scottdube/shrink-fit/BOM.md

# Bill of materials — Shrink-Fit Induction Controller

Controller for the BT30 shrink-fit induction machine - isolated CAN supervision of the rectifier (CR-11)

**InvenTree part** `#782`  ·  **Build** `BO-0002` (Pending)

| Qty | Part | ID | Where it lives |
|---:|---|---|---|
| 1 | ADUM1201 Dual-Channel Digital Isolator | `18` | A3-R8C1 |
| 1 | AITRIP Type-C Supermini ESP32-S3 Dev Board 160MHz | `60` | B3-R6C3, LRD |
| 1 | SN65HVD230 CAN Transceiver Module | `19` | B3-R3C6, RB-25 |
| 1 | CG Solid State Relay SSR-100DD DC to DC Input 3-32VDC to Output 5-240VDC 100A Single Phase Plastic C | `193` | RB-25 |
| 1 | CGELE Aluminum Heat Sink SSR Dissipation for Single Phase Solid State Relay 10A,25A,40A Black Radiat | `192` | RB-25 |
| 2 | Brass Tee Compression Fitting 3/16in OD (5 pack) | `788` | B3-R3C8, RB-25 |
| 1 | MBR60100PT Schottky Rectifier 60A 100V TO-3P | `12` | B3-R2C4, RB-25 |
| 1 | B0505S-1W Isolated DC-DC Converter 5V 1W | `27` | B3-R2C7, RB-25 |
| 1 | Copper Tubing 3/16in OD x 5/32in ID, 5ft | `787` | Assembly & Test |
| 1 | NEMA 6-20P Plug, Male Cord End | `784` | Receiving |

## Notes on individual lines

- **Copper Tubing 3/16in OD x 5/32in ID, 5ft** — Induction coil / cooling circuit tubing
- **NEMA 6-20P Plug, Male Cord End** — Mains cord end, SR-02 cord-and-plug disconnect

---

_Generated from InvenTree on 2026-08-19 — do not edit by hand._
_Regenerate:_ `itq run link_repos.py && write_boms.py`
