scottdube/shrink-fit/hardware/guard-plate/Sketch1.dxf

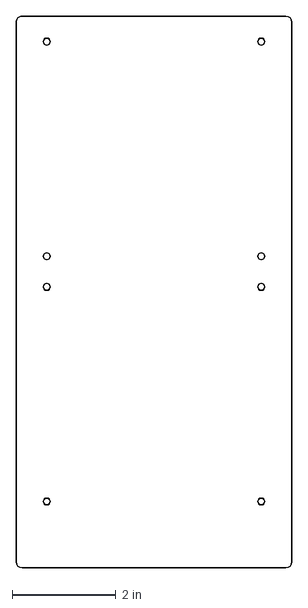
[picture p1: CAD file, 2026-08-29]
hardware/guard-plate/Sketch1.dxf
5.31 x 10.6 in
