scottdube/shrink-fit/(list of files, cad)

Other CAD files:
hardware/guard-plate/Heat Shrink Machine Bottom Guard Plate.dxf
