scottdube/shrink-fit/hardware/shrink-fit-controller/shrink-fit-controller.kicad_pcb

## KiCad design hardware/shrink-fit-controller/shrink-fit-controller.kicad_pcb (2026-09-03)

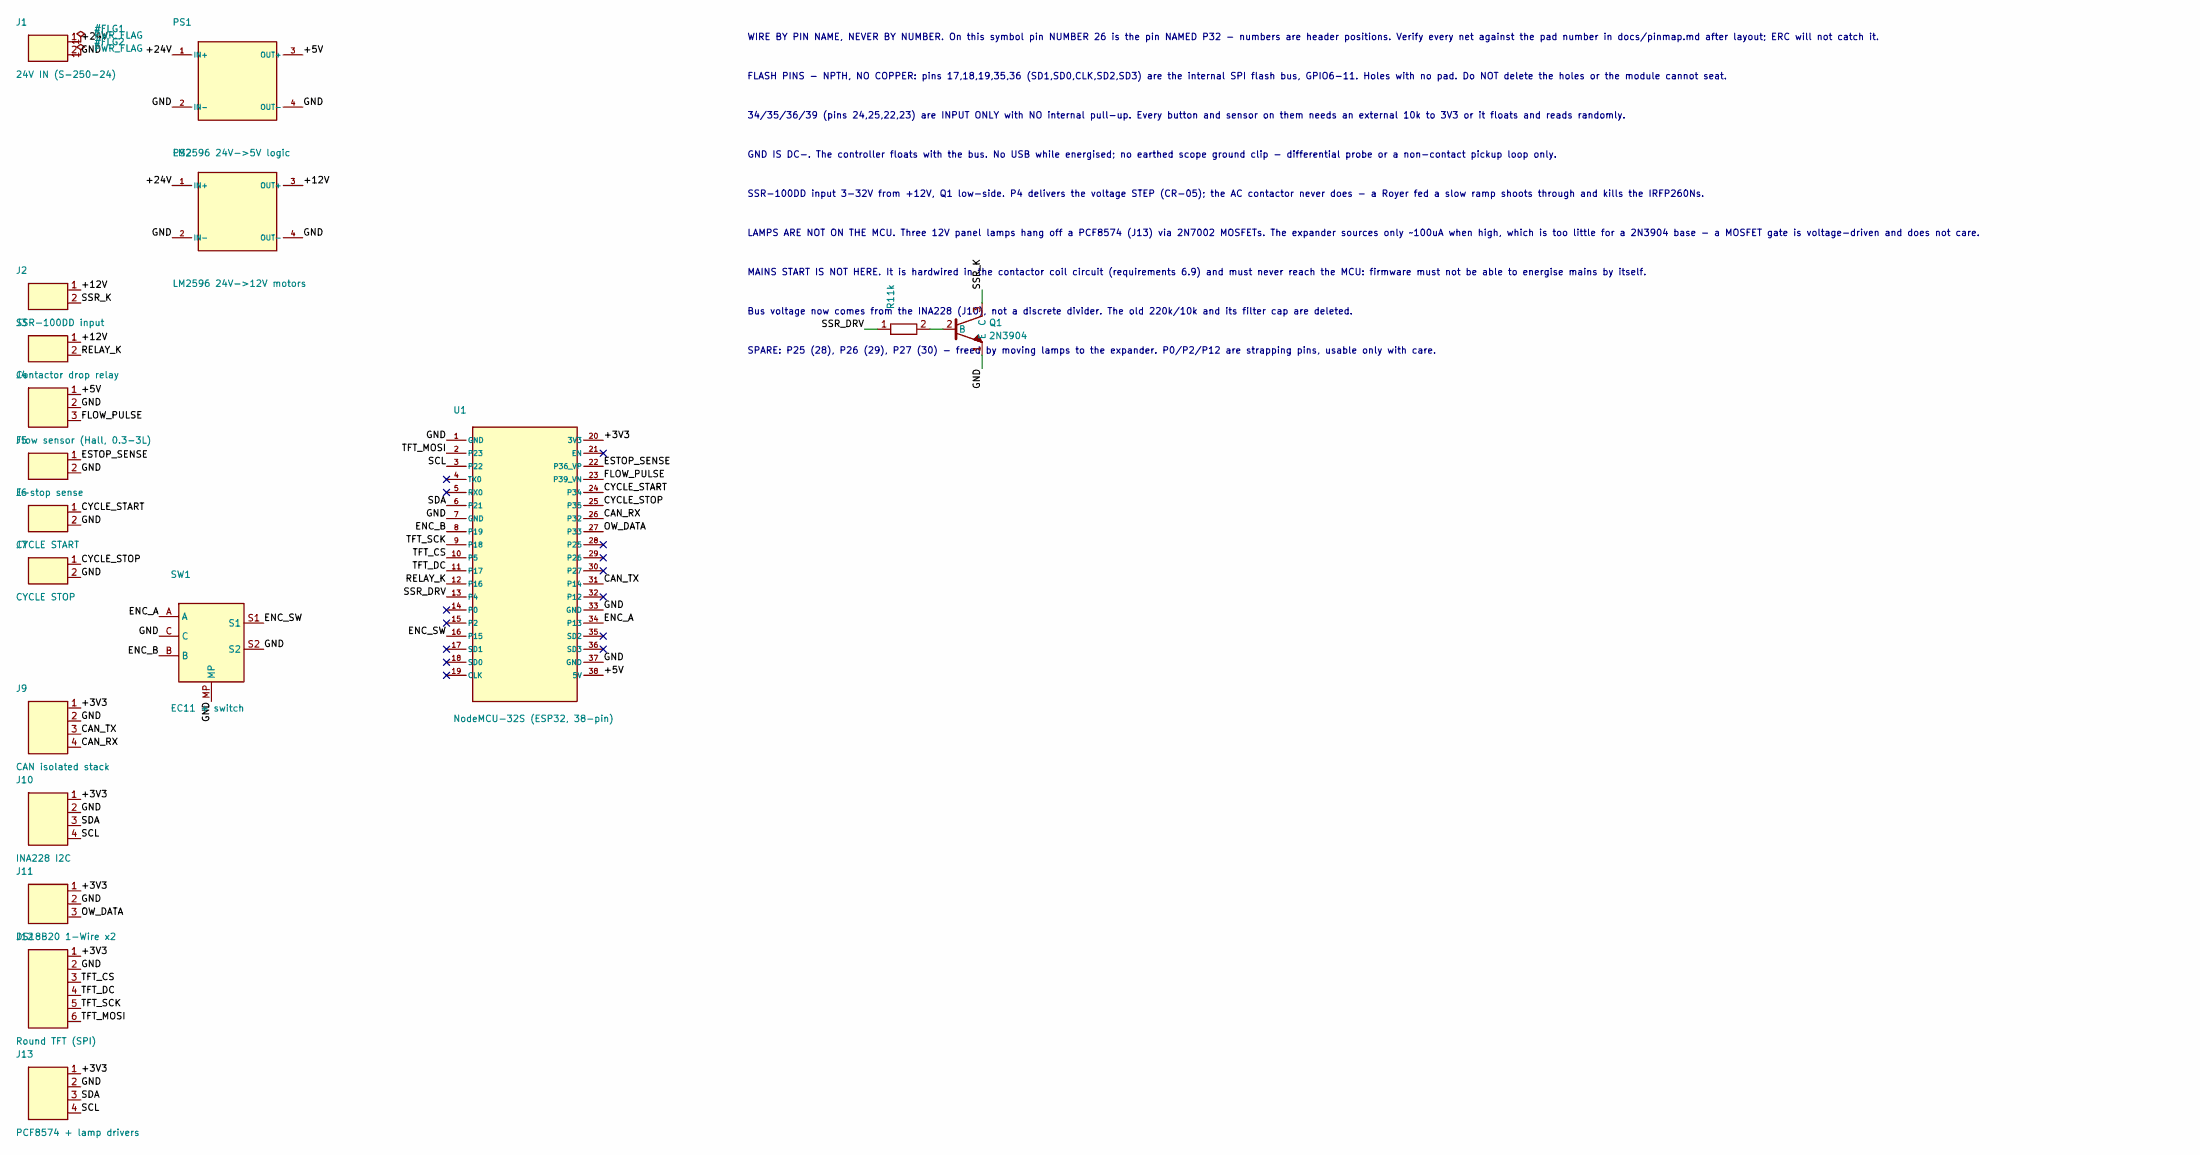
[picture p2: schematic shrink-fit-controller.kicad_sch, Shrink-Fit Induction Controller]

Parts:
J1: 24V IN (S-250-24); PinHeader_1x02_P2.54mm_Vertical_1.78pad
J2: SSR-100DD input; PinHeader_1x02_P2.54mm_Vertical_1.78pad
J3: Contactor drop relay; PinHeader_1x02_P2.54mm_Vertical_1.78pad
J4: Flow sensor (Hall, 0.3-3L); PinHeader_1x03_P2.54mm_Vertical_1.78pad
J5: E-stop sense; PinHeader_1x02_P2.54mm_Vertical_1.78pad
J6: CYCLE START; PinHeader_1x02_P2.54mm_Vertical_1.78pad
J7: CYCLE STOP; PinHeader_1x02_P2.54mm_Vertical_1.78pad
J9: CAN isolated stack; PinHeader_1x04_P2.54mm_Vertical_1.78pad
J10: INA228 I2C; PinHeader_1x04_P2.54mm_Vertical_1.78pad
J11: DS18B20 1-Wire x2; PinHeader_1x03_P2.54mm_Vertical_1.78pad
J12: Round TFT (SPI); PinHeader_1x06_P2.54mm_Vertical_1.78pad
J13: PCF8574 + lamp drivers; PinHeader_1x04_P2.54mm_Vertical_1.78pad
PS1: LM2596 24V->5V logic; LM2596_Module_THT
PS2: LM2596 24V->12V motors; LM2596_Module_THT
Q1: 2N3904; TO-92_Inline
R1: 1k; R_Axial_DIN0207_L6.3mm_D2.5mm_P10.16mm_Horizontal
SW1: EC11 + switch; RotaryEncoder_Alps_EC11E-Switch_Vertical_H20mm
U1: NodeMCU-32S (ESP32, 38-pin); NodeMCU-32S_38pin_THT

Connections:
/+3V3: J9.1, J10.1, J11.1, J12.1, J13.1, U1.20 (3V3); also elsewhere on the board
/+5V: J4.1, PS1.3, U1.38 (5V)
/+12V: J2.1, J3.1, PS2.3
/+24V: J1.1, PS1.1, PS2.1
/CAN_RX: J9.4, U1.26 (P32)
/CAN_TX: J9.3, U1.31 (P14)
/CYCLE_START: J6.1, U1.24 (P34)
/CYCLE_STOP: J7.1, U1.25 (P35)
/ENC_A: SW1.A, U1.34 (P13); also elsewhere on the board
/ENC_B: SW1.B, U1.8 (P19); also elsewhere on the board
/ENC_SW: SW1.S1, U1.16 (P15); also elsewhere on the board
/ESTOP_SENSE: J5.1, U1.22 (P36_VP)
/FLOW_PULSE: J4.3, U1.23 (P39_VN)
/GND: J1.2, J4.2, J5.2, J6.2, J7.2, J9.2, J10.2, J11.2, J12.2, J13.2, PS1.2, PS1.4, PS2.2, PS2.4, Q1.1 (E), SW1.C, SW1.MP, SW1.S2, U1.1 (GND), U1.7 (GND), U1.33 (GND), U1.37 (GND); also elsewhere on the board
/OW_DATA: J11.3, U1.27 (P33)
/RELAY_K: J3.2, U1.12 (P16)
/SCL: J10.4, J13.4, U1.3 (P22)
/SDA: J10.3, J13.3, U1.6 (P21)
/SSR_DRV: R1.1, U1.13 (P4)
/SSR_K: J2.2, Q1.3 (C)
/TFT_CS: J12.3, U1.10 (P5)
/TFT_DC: J12.4, U1.11 (P17)
/TFT_MOSI: J12.6, U1.2 (P23)
/TFT_SCK: J12.5, U1.9 (P18)
unnamed: Q1.2 (B), R1.2

Notes on the sheet:
WIRE BY PIN NAME, NEVER BY NUMBER. On this symbol pin NUMBER 26 is the pin NAMED P32 - numbers are header positions. Verify every net against the pad number in docs/pinmap.md after layout; ERC will not catch it.
FLASH PINS - NPTH, NO COPPER: pins 17,18,19,35,36 (SD1,SD0,CLK,SD2,SD3) are the internal SPI flash bus, GPIO6-11. Holes with no pad. Do NOT delete the holes or the module cannot seat.
34/35/36/39 (pins 24,25,22,23) are INPUT ONLY with NO internal pull-up. Every button and sensor on them needs an external 10k to 3V3 or it floats and reads randomly.
GND IS DC-. The controller floats with the bus. No USB while energised; no earthed scope ground clip - differential probe or a non-contact pickup loop only.
SSR-100DD input 3-32V from +12V, Q1 low-side. P4 delivers the voltage STEP (CR-05); the AC contactor never does - a Royer fed a slow ramp shoots through and kills the IRFP260Ns.
LAMPS ARE NOT ON THE MCU. Three 12V panel lamps hang off a PCF8574 (J13) via 2N7002 MOSFETs. The expander sources only ~100uA when high, which is too little for a 2N3904 base - a MOSFET gate is voltage-driven and does not care.
MAINS START IS NOT HERE. It is hardwired in the contactor coil circuit (requirements 6.9) and must never reach the MCU: firmware must not be able to energise mains by itself.
Bus voltage now comes from the INA228 (J10), not a discrete divider. The old 220k/10k and its filter cap are deleted.
SPARE: P25 (28), P26 (29), P27 (30) - freed by moving lamps to the expander. P0/P2/P12 are strapping pins, usable only with care.

Board: 2 copper layers, 18 parts (0 on the bottom side), 25 nets, no tracks yet.

Other parts of the board:
J8: Encoder EC11; PinHeader_1x05_P2.54mm_Vertical_1.78pad

Their connections:
/+3V3: J8.1; also elsewhere on the board
/ENC_A: J8.3; also elsewhere on the board
/ENC_B: J8.4; also elsewhere on the board
/ENC_SW: J8.5; also elsewhere on the board
/GND: J8.2; also elsewhere on the board
