scottdube/shrink-fit/(commit log)

2026-08-20 Shrink-fit induction controller: firmware and design docs
    BT30 induction shrink-fit machine — bring-up and test-rig firmware, R48 CAN
    interface, energy metering, plus requirements, roadmap and status docs.
    Adds a .gitignore first: .pio/ was 26 of the project's 27 MB — build output,
    third-party library clones, and a firmware.map embedding absolute local paths.
    None of it belongs in the history.
    BOM.md is generated from InvenTree (part #782, BO-0002, fully allocated) and
    records where each part physically lives.
2026-08-23 Drilled retention knob earns its place twice
    MR-16 already rested on the drilled knob venting the blind bore. Scott,
    2026-08-23: it is also the passage a welding wire runs up to push a stuck shank
    out during removal. So a solid knob does not just re-instate the hold-down
    requirement, it removes the recovery path for a stuck tool -- and that second
    consequence has no substitute.
    Recorded here and in shop-inventory/docs/TRAPS.md because the purchasing view
    and the machine-design view each only saw one of the two reasons.
2026-08-26 Bus divider moves to 220k/10k; SSR driver is a 2N3904
    Both changes come from checking stock properly instead of specifying first and
    sourcing later.
    180k does not exist here - the EAONE kit steps 100k -> 220k -> 300k - so the
    19:1 divider was never buildable. 220k/10k gives 23:1, keeps 53.5V at 2.33V,
    and changes one value. Rejected 100k+68k+10k in series (18.8:1): it hits the
    number, but spends three parts and two extra joints to avoid a calibration the
    `cal` command performs anyway, and every added joint sits in the sense path of
    a kW oscillator.
    The driver was going to be a 2N7000 that had to be ordered and is marginal at
    3.3V anyway (Vgs(th) to 3.0V). 24x 2N3904 were already in L2-D4.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
    [config.h, testrig.cpp]
2026-08-26 KiCad project for the controller: full scope, staged populate
    Skeleton only - .kicad_pro with the milled-board DRC, a validated empty
    schematic, and the design captured in hardware/README.md.
    Scope is the full Phase 2 controller with every block footprinted, populated in
    stages. Rejected a Phase-1-minimum board: it mills sooner, but the cost of a
    respin is not the copper, it is desoldering everything already fitted. A
    footprint on a board being milled anyway is free, so the asymmetry only runs one
    way. Note this is NOT the enclosure's "expensive to redo" argument - a milled
    board is an afternoon - and the two should not be conflated.
    DRC values are copied from sln-geo-aux-heat's .kicad_pro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
    [shrink-fit-controller.kicad_sch]
2026-08-26 Super Mini symbol, built from photographs of the actual board
    The pinout came from the two images already attached to InvenTree part #60 -
    Scott's own photos of both faces, iPhone-EXIF 2026-08-15 - not from a vendor
    listing. That distinction is the whole point: reading a stock listing as fact
    is what produced two wrong claims earlier in this session.
    Using both faces rather than one is also deliberate. Handedness is the failure
    that costs a board, and a single view cannot detect a mirror - the solder-side
    image has to mirror the component-side image, and it does. HW-747 V0.0.2 on the
    silk also confirms the board variant against platformio.ini rather than assuming
    "38-pin ESP32" is a specifi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
2026-08-26 Dimensions from the drawing; logic supply resolved to LM2596
    The dimensioned drawing is a third independent source for the pinout and it
    arrives rotated 90 degrees from both photographs with the labels still matching.
    That matters more than the millimetres: a mirror cannot be detected from one
    view, and three views in three orientations is what actually rules it out.
    23.50 x 18.00 board, and the 20.32 pin span self-validates the pitch at exactly
    8 x 2.54 - so pitch never needs measuring. One number is still missing: the
    row-to-row hole centre distance, which the drawing does not dimension and which
    cannot be read off a render because the pads overhang the outline. 17.78mm is
    recorded as a P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
2026-08-26 Correct the 12V earth test: a 2-prong wall wart has no pin to meter
    The test as written was impossible. It called for metering the supply's V-
    against the earth pin of its own AC cord, and a Class II wall wart has no earth
    conductor at all. Corrected to meter against the MACHINE's chassis earth, which
    is earthed through the NEMA 6-20 cord and is where an unwanted bond would
    actually show up.
    The correction also changes the conclusion in the reassuring direction: no earth
    conductor means the output cannot be earth-bonded through its cord, so tying V-
    to DC- imports no earth reference and the SR-11 objection dissolves for this
    case. Kept the test anyway, because the answer flips completely if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
2026-08-26 Decompose the ZVS kit: 8 machine components were untracked
    Every core component of this machine - the ZVS module, the 53.5V PSU, the coil,
    the pump, the 12V adapter, the breaker and the ammeter - existed only inside one
    InvenTree record sitting at qty 0. Inventory would have answered "you own none
    of this" about a machine on the bench.
    Contents come from the seller's own Package Included list rather than from
    memory or from the photographs, so quantities are vendor-stated against a box
    that was received - neither divided nor inferred. Decomposed to match the
    established pattern (EAONE resistors, McIgIcM transistors): children carry the
    stock, #100 stays at qty 0 so the purchase history surv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
2026-08-26 Schematic drawn and netlist-verified; footprint adopted after de-trapping
    The schematic is generated (tools/gen_sch.py), not hand-drawn, so the pinout
    truth lives in one reviewed table instead of ninety mouse placements. ERC came
    back 0/0, but the check that matters is the netlist-vs-expectation table: all
    15 U1 nets verified on their header-position pads, and the divider and driver
    chains verified by full membership, catching nothing wrong precisely because
    the symbol was built from three sources first.
    Two generator bugs were caught by the validation loop itself: a regex
    alternation mangled the one-letter symbol names (R, C) when prefixing the
    embedded library, which cascaded into all 16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
    [shrink-fit-controller.kicad_sch]
2026-08-27 checkpoint: traps recorded, and a retraction on row spacing
    Retracting a claim made earlier today: the found footprint did NOT settle the
    Super Mini row spacing. Its 15.24mm was accepted because it was internally
    self-consistent, which is the same error as taking the first search hit - the
    number was never measured. A photogrammetric attempt is recorded in TRAPS.md as
    a negative result rather than deleted: the two pad columns disagreed by 1.35mm
    and the built-in self-check (pad 1 to pad 9 must equal exactly 20.32) returned
    25.16 and 23.79, so the scale was wrong and every derived number with it. The
    cheap decisive test needs no calipers - 0.600in straddles a breadboard centre
    channel and 0.7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
    [shrink-fit-controller.kicad_sch]
2026-08-27 The board already has its freewheel diodes; and the caps say 50 kHz
    Two corrections from putting a meter and a microscope on the actual board
    instead of reasoning about it.
    MR-22 was wrong about where the protection is needed. The underside carries six
    FR307 in parallel straight across the DC rails, cathodes to DC+ - a catch-diode
    array, correctly sized. I dismissed them twice for being 3 A parts on a 58 A
    bus, which compared a continuous rating against a transient duty: a catch diode
    only conducts while the choke field collapses, and the surge rating is 150 A
    each, so 900 A for 8.3 ms against ~58 A for a few ms. Sixteen times margin and
    1.4 mW average. Six small fast diodes beat one big sl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
2026-08-27 MR-22 closes: the machine already has every diode it needs
    The SSR is a CoG ZGT-100 DD - 100 A / 220 VDC output, 3-32 VDC control, load on
    the positive side. That was the open question, and 220 V against a 53.5 V bus is
    4x headroom rather than the 5-60 VDC that would have made a transient dangerous.
    But the headroom is not why MR-22 closes. The onboard FR307 array clamps the FAR
    end of the SSR cable, so it protects the SSR as well as the board. When the SSR
    opens, the chokes freewheel into those diodes and hold the board input at about
    -0.7 V; the cable current then decays into the same diodes at 0.7 V / 2 uH =
    350 kA/s, clearing 58 A in ~166 us with only the clamp voltage across the cable.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
2026-08-27 12V supply verified from the nameplate, not inferred from the plug
    Model 1230: AC 100-240 V in, 12 V 3 A out, centre-positive, Class II mark
    present, 2-prong. The Class II mark is the load-bearing part - it is what makes
    the SR-11 bond structurally impossible rather than merely absent, and it is now
    evidence instead of an inference from "it looks like two prongs".
    Also records what the nameplate says that nobody would think to ask: dry
    location only, which matters solely because this shares a cabinet with a water
    loop, and centre-positive, which matters when it gets wired to a terminal
    instead of a barrel jack.
2026-08-27 Bench measurements close the footprint and delete the cut-away plate
    Row spacing measured at 15.2 mm, confirming the found footprint's 15.24 and
    finally killing my 17.78 prediction - which was geometrically impossible all
    along, since 17.78 on an 18.00 mm board puts the hole centres 0.11 mm from the
    edge. I had the drawing that ruled it out and did not check it against the
    prediction.
    Standoff height is 26.9 mm, which is more generous than assumed and removes a
    fabrication requirement: the carriage needs only a plain flat plate, because
    nothing can bridge that gap to the live underside. The cut-away or insulated
    plate previously specified is unnecessary.
    Added one check that these raise ra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
2026-08-27 Coil exits the board's short end: the layout was right, the saving is not
    Terminal geometry measured: 70 mm centre-to-centre, 13 mm off the board, and the
    leads exit the short end in the plane of the board. Mounted long-edge vertical
    with that end down, the coil hangs below - so the "coil beside the board"
    alternative, which would have bought 65 mm of column height, does not exist.
    Upright stays at ~520 mm, or ~480 with the nest dropped flush. Recording the
    negative result because the 65 mm was carried as an open lever for two days.
    13 mm against 26.9 mm of standoff puts the stubs inside the gap with ~11.5 mm
    clear beneath, confirming a plain flat carriage plate for the third time.
    70 mm i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
2026-08-27 Standoffs isolated: plain carriage plate confirmed, RF caveat recorded
    All eight brass standoffs measure open to both DC+ and DC-, so no tank potential
    reaches the carriage plate, the rail, or the column. Plain metal plate bolted
    straight to the blocks - fourth independent confirmation, and the last of the
    three fabrication features this measurement session deleted.
    Recorded the caveat that the measurement does NOT cover, because it would be easy
    to read "isolated" as settled: DC isolation is not 100 kHz isolation. The plate,
    rail and column are a large chassis-bonded conductor inches from the tank and are
    capacitively coupled to it regardless. The layout consequence is that sensor
    leads mu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
2026-08-27 Guard plate: hole pattern derived from the fan standard, not measured
    Scott's point, which I talked past twice: the eight brass standoffs ARE the fan
    bolt pattern. Two 80 mm fans stacked touching give exactly eight holes - two
    columns 71.5 apart, four rows at 0 / 71.5 / 80 / 151.5 - and eight is the stud
    count the kit sheet states. The 8.5 mm gap between the inner rows is where the
    two fan frames meet, 4.25 in from each frame edge, which is the fingerprint
    confirming the derivation rather than a coincidence.
    So the pattern needs no measuring at all. gen_guard.py derives it from fan size
    and pitch, which means a different fan size is a one-line change rather than a
    re-measure.
    Slots are fun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
2026-08-27 Fans are 120 mm: envelope corrected, +45 mm of column, easier rail
    The roadmap carried "2x 80 mm fans, 200 x 150 x 120" for this block. Two 120 mm
    fans stacked are 240 mm on their own, so that envelope was never possible - it
    went unchallenged because nobody multiplied it out. Now ~250 x 140 x 150.
    Costs about 45 mm of column: upright ~565 mm, or ~525 with the nest flush.
    Buys something back on the rail, though. A longer board lets the two carriage
    blocks sit further apart, and 180 mm centres instead of 140 cuts the per-block
    moment couple by 22% for free. A 450 mm rail still covers it - 390 needed at the
    wider spacing - so the rail decision is unaffected.
    Guard plate regenerated by chang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
2026-08-27 Guard plate 270x135, solid - the drainage argument does not survive vertical
    Sized to Scott's numbers: 270 x 135 gives ~2 mm clear each end on the long axis
    and covers the heatsink fins, which stand ~4 mm proud of the board edge. Stud
    pattern centred: X columns 105 apart, Y rows 7.5 / 112.5 / 127.5 / 232.5, M3
    clearance at 3.4 which laser kerf opens to a useful ~3.5.
    Removed the slots. They were for leak drainage - a solid plate under a
    HORIZONTAL board turns the standoff gap into a tray, and that gap holds the
    coolant terminals. But the board stands long-edge vertical, which makes the gap
    a vertical slot that drains out its own open bottom edge. The reason was sound
    for the orientation I f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
2026-08-29 FIRST CONTROL: the SSR closed on command
    testrig.cpp flashed and run for the first time - written 08-15, compiling clean
    since, never loaded because PlatformIO had vanished and I recorded it as needing
    reinstall. Opening the VS Code extension rebuilt penv on its own, which is what
    the status note guessed would happen.
    Commanded r 5, GPIO10 held high for exactly 5000 ms, SSR control LED lit for the
    duration. That closes the Phase 1 control chain end to end: GPIO10 -> R1 -> Q1
    -> SSR-100DD control input. Every link in it is now measured rather than
    designed.
    Two bench details worth keeping. Scott caught that USB 5V and the 5V pin are the
    same net on the Super Mini before wiring the LM2596 in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
    [Heat Shrink Machine Bottom Guard Plate.dxf, Sketch1.dxf]
2026-08-29 SSR output proven: Phase 1 control circuit is complete
    12 V through 1 k through the SSR output, meter across the SSR: 12 V idle, near
    zero for the full commanded 10 s, back to 12 V. Output transistor conducts and
    releases on command, so the chain GPIO10 -> R1 -> Q1 -> SSR control -> SSR output
    is measured end to end. Nothing in it is inferred any more.
    Correcting the record on two things that looked like faults and were not. The run
    that appeared to last a second was my test script writing a newline to "just
    listen" - the firmware aborts on any incoming byte, which is correct and
    documented behaviour. And 12 V across the SSR reads as blocking, not passing;
    measuring across a switch is inver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
2026-08-29 State indication: lamps carry state, a TFT would carry numbers
    Recording the requirement Scott raised - the machine must show which of IDLE /
    HEATING / COOLDOWN / FAULT it is in - along with the argument that settles the
    hardware question, because it is not the obvious one.
    A 1.28in round TFT is richer and it is the wrong primary indicator, for a reason
    that has nothing to do with cost or effort: a frozen TFT still shows its last
    frame. A hang, a locked SPI bus, a crash mid-cycle, and it sits there reading
    HEATING when nothing is heating - failing deceptively, toward exactly the reading
    you least want to trust. A lamp driven by a live loop stops blinking when the
    loop stops, so its failure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
    [config.h, testrig.cpp]
2026-08-29 Test rig runs untethered: two buttons and a state lamp, no laptop
    GPIO48 confirmed by observation - all three patterns read correctly on the bench.
    It is a plain LED, not the addressable RGB I assumed from a photograph, and
    driving it with neopixelWrite() had been producing meaningless flicker. Also
    worth recording that this is the LED that looks like a power indicator; the
    module has no separate one, which is why it read as "always on" before.
    Both buttons verified from the serial log captured while they were pressed:
    start, abort at 4347 ms of a commanded 10 s run, and the refusal during cooldown.
    Every path exercised.
    This is the change that actually matters for safety rather than conve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
    [config.h]
2026-08-29 Two Waveshare round LCDs are owned; the display argument is unchanged
    Catalogued #470 at qty 2 - the fourth uncatalogued item surfaced today after the
    ZVS kit contents, whatever is on WS1, and the 1/8in acrylic. The pattern is
    consistent enough to be worth naming: components are tracked, materials and
    modules are not.
    Marked the count as a STATED MINIMUM rather than a tally, per the evidence tiers
    - Scott said "at least two", which is not the same claim as two. Also recorded
    that these are genuine Waveshare rather than clones, because clone GC9A01 boards
    differ in pinout and init sequence and that distinction costs a debugging session
    if it is lost.
    This makes the Stage-4 data display cost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
2026-08-30 Correct the LCD provenance: mixed, not confirmed genuine
    I recorded "GENUINE Waveshare, not a clone" from a passing remark and hardened it
    into a fact. Scott's follow-up is that one may well be a clone. Corrected to what
    is actually known: two units, GC9A01 class, both with the 8-pin Waveshare header
    arrangement, provenance mixed.
    The 8-pin header is the useful part and worth keeping - it means the wiring
    should match the Waveshare reference regardless of who made the board. What it
    does not guarantee is the controller: boards sold as GC9A01 sometimes ship an
    ST7789 or a different init sequence. So the instruction is verify the controller
    on first use, not the branding, which is the check t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
2026-08-30 status.md: retire two entries that are no longer true
    The controller section still said testrig.cpp had never been flashed and that
    PlatformIO needed reinstalling. Both were true when written and both were
    resolved yesterday - the extension rebuilt penv by itself, and the rig has since
    run untethered on buttons. Struck through rather than deleted so the sequence
    stays legible: the original note predicted the reinstall, and it was right.
2026-08-30 Duration button for the rig: built and compiling, deliberately NOT flashed
    The calibration protocol is an iteration on duration - "heat ~25% longer, try
    again, repeat" - so with duration settable only over USB, every step of the
    actual job would mean plugging a laptop back in. That defeats the buttons, and
    it would have bitten the first time a tool did not go in rather than during
    repeat 20 s runs.
    Third button steps a ladder (5/10/15/20/30/45/60, wrapping) and blinks the new
    value back as one flash per 5 s, so the setting is readable with no display and
    no serial. Same principle as the state lamp: pattern carries the signal.
    Idle only. Changing duration mid-run would make the log disagree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
2026-08-30 R-11 CONFIRMED: the PZEM reads 44% low inside the field
    The PZEM reported 29.7 V during a run while a second meter on the same PSU
    terminals read 53 V+ throughout. The supply never sagged. R-11 has been carried
    as "suspected in the first-light readings" since 2026-08-09; this is the direct
    measurement that settles it.
    Withdrawing today's coupling and equilibrium figures. They were computed from
    PZEM power readings and those readings are now known to be wrong by at least 44%
    on the voltage channel - in the direction that makes delivered power look lower
    than it is, which is the direction that invites longer cycles to compensate.
    Two things survive. The coupling argument is geometric: a 5/8i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
2026-08-30 OTA for the test rig, gated to idle only
    WiFi credentials live in NVS and are set once over serial (wifi <ssid> <pass>),
    so nothing lands in git and the rig still works with no network configured at
    all - it just skips WiFi and says so.
    ArduinoOTA.handle() is called ONLY when state == IDLE. An update cannot start,
    and cannot proceed, while a cycle is running or cooling. onStart also forces the
    field off as belt and braces, though the guard means we should never arrive there
    hot. An update landing mid-cycle with the field on is the failure this is written
    to prevent.
    Verified rather than assumed that OTA is actually possible here: default.csv
    carries app0/app1 at 0x140000 each, so there are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
    [config.h, testrig.cpp]
2026-08-30 Record the no-OTA-password decision so it does not read as an oversight
    I built OTA without setPassword() and only noticed when asked whether it was
    safe. Scott's call is to leave it open: bench rig, trusted shop LAN, machine
    never unattended.
    Recording it in config.h rather than leaving it implicit, because an unlocked
    OTA on a controller that switches 53 V into a 3 kW heater looks exactly like a
    mistake to anyone reading later - including me. The note says it was considered,
    names the conditions it depends on, and gives the two-line fix for when those
    conditions change.
    [config.h]
2026-08-30 OTA works: VLAN reverse path and WiFi power save, in that order
    Two independent faults, and separating them was the whole job. The IoT VLAN
    blocked espota because it needs the DEVICE to open a connection back to the
    laptop, and IoT rules permit LAN->device while blocking device->LAN. Ping
    succeeded throughout and told us nothing, which is the trap worth remembering.
    Scott's test - put the laptop on the same VLAN - isolated it in one move.
    Separately, Arduino leaves WiFi power save on, so the radio sleeps between
    beacons: 42-140 ms latency before, 4-8 ms after WiFi.setSleep(false). That fix
    was delivered over OTA, which proved the loop end to end.
    The diagnostic that mattered was mDNS. shri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
    [testrig.cpp]
2026-08-30 Duration ladder to 10 s rungs, and hold-to-go-down
    Scott's call on 10 s rungs, and it fixes the read-back as a side effect: one
    flash per 10 s makes the whole ladder 1..6 flashes. The 5 s version put 60 s at
    twelve flashes, which nobody can count - I picked one-flash-per-5s without
    thinking about what the top of the range looked like.
    Little is lost. These timed cycles exist for coil comparison and rough
    exploration; the machine doses on ENERGY, so fine time resolution is the wrong
    instrument for the job it is eventually doing.
    Added hold-to-step-down because the first version could only wrap. Being at 30
    and wanting 20 cost six presses, and the calibration protocol converges from both
    sid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
    [testrig.cpp]
2026-08-30 One indicator, one signal - the three-lamp argument, found on the bench
    I gave the rig's single LED two jobs: a continuous state pattern and a transient
    count for the duration read-back. They collide. A readout flash cannot be told
    from a state flash, so the count gains or loses a blink depending on when the
    button is pressed relative to the idle pattern. Scott found it in minutes of
    actual use.
    Recording it against the three-lamp decision in this file because it is the same
    mistake at small scale, and it converts that decision from an argument into an
    observation. The rule is one indicator carries one signal; a second thing to say
    needs a second lamp, not a cleverer pattern on the first.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
2026-08-30 LED read-back gets a dark bracket; record the two TC clocks
    The single status LED carries a continuous state pattern and a transient
    duration count, and Scott found they blend: press the button near an idle
    blink or a cooldown gap and the count gains a phantom flash at one end.
    500 ms of darkness either side of the readout makes it countable. This is
    a legibility patch, not the fix -- one lamp per signal is the fix, and
    roadmap.md already argued for it before I built this.
    Rejected the alternative of encoding duration differently (long/short
    pulses, a burst rate): it keeps two signals on one lamp and adds a code
    Scott would have to memorise. Counting flashes needs no key.
    TRAPS: TR-04's 20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
    [testrig.cpp]
2026-08-30 Idle displays the duration continuously; the button only changes it
    Scott asked how long to wait after a duration press before pressing
    again to check the setting. There is no such interval, and the question
    exposed the defect: every press stepped the value, so pressing to read
    incremented, and pressing again to confirm incremented again. He had been
    chasing the setting he was trying to observe.
    The dark-bracket patch an hour ago made the count legible and left this
    untouched -- symptom, not cause. Idle is now N flashes + 1.6 s gap on
    repeat, so the duration is on display whenever the rig is not running,
    and the button is a write-only control.
    Rejected a read-only gesture (double-tap, or a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
2026-08-30 First real temperature, and the current channel falls too
    320 C in 30 s on 1" bar with an unpacked thermocouple -- a floor, not a
    peak. Inside the 250-400 C shrink window on a coil that is still shorted
    turn-to-turn. The gate question (has this thing got the power at all?)
    is answered yes.
    PZEM current read 3.5 A against 23 A on the clamp. Recorded the energy
    argument rather than the instrument comparison, because the comparison
    does not actually prove anything: if the clamp was round a tank
    conductor, 3.5 A DC in and 23 A circulating is unremarkable for a
    resonant load. 3.5 A at 53 V for 30 s is 5.6 kJ, and 300 K into even a
    100 g slug needs ~14 kJ -- impossible regardless of clamp placeme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
2026-08-30 Strike the PZEM validation from Proven; the DC clamp was never bought
    Scott asked what the second clamp meter was for. The answer is in
    bom.md: the UNI-T UT210E was explicitly DECLINED, because a Hall DC
    clamp has to sit on the DC lead inside the field that corrupts every
    other sense lead, whereas the AC clamp reads mains at 60 Hz feet from
    the coil and is RF-immune by placement. Today proved that call right --
    the mains clamp gave the number we trust, the in-field PZEM did not.
    status.md still listed a DC clamp as the bring-up reference, which
    contradicted bom.md and would have sent us buying one; removed.
    Also struck 'PZEM validated against the AC clamp = 88% efficiency' from
    the Proven l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
2026-08-30 The '10% of target' figure was the same PZEM error, restated
    Caught while answering a question about which clamp meter is which:
    'Power is ~10% of target' sat two lines below the PZEM validation I had
    just struck, and derives from the same 297 W reading. Real input measured
    at the mains is ~1.8 kW -- around 60% of the kit rating.
    This one had teeth. A tenfold power deficit and a 1.7x deficit call for
    different projects: the first says the topology or the supply is wrong,
    the second says wind a better coil. The roadmap's coil work was already
    the right move; it was being justified by a number that overstated its
    payoff by 6x.
2026-08-30 DC clamp reads 33 A: confirms the mains math, refutes my vindication claim
    Independent confirmation first: 33 A on the feed against 32.6 A derived
    from the mains clamp an hour earlier, two different physical principles
    at opposite ends of the machine, inside 2%. The input power figure is now
    solid in a way no single instrument could have made it.
    Backing out a claim I made this afternoon. I wrote that the day
    'vindicated exactly' bom.md's decision to decline a DC clamp -- the
    argument being that a Hall clamp near the tank would be corrupted like
    everything else. Scott then used one to take the decisive reading, in
    that same field, uncorrupted. The PZEM's vulnerability is its sense
    leads; a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
2026-08-30 Temper colours corroborate the thermocouple, and map the coupling zone
    Oxide bands read ~310 C at the bored end against 320 C on the
    thermocouple. Worth more than the small numeric gap suggests: a K-type
    junction in an RF field and a surface oxidation reaction share no failure
    mode, so this is the first temperature figure not resting on a single
    instrument -- which matters on a bench where the last two instruments
    both lied.
    The gradient is the better half of the photograph. The bands draw the
    coupling zone without needing a probe: hot over the top two-thirds,
    steep transition, cold foot. That was the free parameter in this
    morning's energy reconciliation, which had to assume 60-70% of the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
2026-08-30 The coil was never shorted; the coupling deficit is geometric
    Scott asked what 'shorted coil' meant. It meant nothing -- I had carried
    'turns touching (shorted)' forward from an earlier note without checking
    it against quickstart-1-8.md, which specifies winding turns touching AND
    insulating them. Touching is the design; only bare touching turns short,
    and the coil carries the sleeving design-references.md A5 calls for.
    Not just wrong, load-bearing. I twice presented 320 C as achieved
    despite a handicap, which implied headroom sitting in a repair. The
    actual deficit is geometry: a 25 mm bar in the stock 60 mm coil couples
    to (25/60)^2 = 0.17 of the bore. Both diagnoses point at 'rewind the
    c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
2026-08-30 Haas publishes no temperature spec; a low-reading TC defeats CR-02
    Fetched 04-1424 rather than relying on the docs' 'not published' note:
    the page carries bore, gage, concentricity and RPM and no thermal
    parameter of any kind. That closes the waiting half of OQ-3 -- there is
    no Haas figure coming, and the 350 C ceiling is ours to defend rather
    than a spec to cite.
    Pushed back on Scott's read that a low thermocouple is manageable with
    time and power. It is, for reaching temperature. It is precisely wrong
    for the ceiling: CR-02's 350 C flag and 375 C lockout fire on the
    thermocouple, so a probe reading low never trips them and 380 C actual
    displays as 340 C with the holder tempering. CR-02 is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
2026-08-30 TC identified from photo: Adafruit glass braid, trim the tip sleeve
    Photograph settles it -- white fiberglass braid with blue tracer and a
    black anti-fraying sleeve at the tip, which is the Adafruit part. The
    smoke was that sleeve and nothing else, so there is no PTFE exposure and
    nothing to buy: trim it and the probe is rated 500 C against the ~130 C
    it was being run at.
    Recorded the failure mode the trim opens up, because it is the kind that
    does not announce itself. A thermocouple reads at the hottest point
    where its two conductors touch, not at the bead -- the bead is the
    junction only because it is the sole contact. Once the outer braid can
    fray, a second contact further back in a hott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
2026-08-30 The TC tip sleeve is marked 125 C -- its operating limit, not its shrink point
    Scott read the 125 C marking as the temperature at which the tubing
    shrinks. On heat-shrink that number is the maximum continuous operating
    rating; polyolefin shrinks at roughly 90-120 C. The distinction is worth
    recording because it changes what the marking was telling us: not a
    processing note but the limit itself, printed on the part, while it ran
    at 2.5x it.
    Confirms the material as polyolefin rather than PTFE, which retires the
    polymer-fume-fever caution raised earlier -- acrid, not hazardous.
2026-08-30 OQ-3 answered: Haas states 400 C, and our 30 s cycles are just arithmetic
    Scott found the HSF-325 operation manual -- Haas's own shrink-fit
    machine. It states twice that the maximum recommended heating
    temperature is 400 C and that above it toolholders may be damaged. Our
    ceiling is 350 C, and its recorded justification was that no
    manufacturer figure existed. It does now.
    That matters beyond a number. requirements.md 4.3 estimated the 1/8"
    holder wants ~410 C, above our ceiling, and that was THE blocking risk
    for the project's stated goal. Against 400 C the gap is 2.5% on a
    figure the doc itself flags as unsourced.
    Recorded the decision rather than making it. Raising a limit that
    protects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
2026-08-30 Trace the 1.75 kW figure, and own peak-quoted-as-average
    Scott challenged the 1,800 W number. It holds -- 33 A DC clamp x 53 V
    second meter = 1,750 W with nothing assumed, corroborated independently
    from the mains end at 1,840 W less PSU losses. Recorded the derivation
    so it is not a number people have to take on faith again.
    Two honest weaknesses recorded alongside it. The 240 V mains was taken
    from an old status.md line and never put to Scott; what actually
    supports it is that the two paths only agree at 240 V, which is
    inference rather than a reading. And both currents are PEAKS that I then
    multiplied by 30 s as though sustained -- resistivity climbs and
    coupling shifts as the work heats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
2026-08-30 1.75 kW is an operating point, not a capability -- and that is a hazard
    Scott's second challenge to the number was the right one. The
    measurement holds (33 A steady, 240 V AC confirmed), but a Royer draws
    what its load permits, so what I measured is what THIS coil and THIS bar
    demand. I used it to characterise the machine, which it does not do.
    The consequence is not bookkeeping. Draw is 33 A of an available 56.1 A,
    so there is ~1.7x headroom, and improving coupling is precisely what
    collects it. The 19.5 mm coil is a large coupling improvement over the
    60 mm one, which means a 30 s cycle that gave a 300 K rise could
    approach a 500 K rise on the new coil -- past 400 C, into holder damage,
    o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
2026-08-30 Bracketing protocol for the first real holder
    Scott's rule: underestimate the time and add to it rather than trying to
    predict it. Correct, and for a reason worth stating -- under-heating
    costs a cycle, over-heating costs a holder, and lopsided costs mean
    there is no case for aiming at the centre.
    Recorded three refinements the bare rule does not cover. Heat is
    cumulative, so a second attempt on a 200 C holder is not a run from
    ambient and fixed increments accelerate up the ladder. The hazard band
    is MARGINALLY under rather than well under -- a nearly-expanded bore
    takes the tool partway and seizes on it, which is worse than a bore that
    refuses it, so creeping up in 1 s slices maximises exp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
2026-08-30 Phase-2 stock check: CAN fully covered, current sense entirely absent
    Scott's instinct was right on both counts. CAN needs nothing bought --
    three SN65HVD230s, three ADuM1201s for isolation, and the ESP32-S3's
    internal TWAI replaces the MCP2515 the BOM still lists. Marked that line
    stale.
    Current sensing has nothing at all. The Hall parts in stock are magnetic
    field sensors rather than current sensors -- usable only with a core and
    a calibration campaign, which is a project and not a part.
    Recorded a reconsideration of the INA228 rather than just pricing it.
    It is a shunt sensor with sense leads in the field, which is the exact
    architecture that failed today, while the DC clamp -- Hall, no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
2026-08-30 CR-02 assumes the measurement CR-01 exists to avoid
    Scott asked how a thermocouple attaches to a tool holder. It does not:
    holders are loaded and unloaded every cycle, cannot be drilled or
    clamped, and a spring probe on a 400 C nose has worse repeatability than
    the quantity it reads. CR-02 specifies sampling nose temperature and
    never specifies the mechanism.
    The contradiction beneath it is worse than the omission. CR-01 energy
    dosing exists BECAUSE per-cycle holder temperature is unmeasurable;
    CR-02 assumes it is measurable. Both cannot hold, and CR-02 is the one
    with no mechanism behind it.
    Haas decides the direction: their production machine measures no
    temperature at all, running diame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
2026-08-30 Drop the MAX31855: coolant is a 1-Wire job, and nothing else needs K-type
    Scott: a K-type and a cold-junction-compensating amplifier for water
    that never passes 60 C is the wrong instrument. Two DS18B20 waterproof
    stainless probes are already in stock at B3-R4C8.
    The removal goes further than CR-07. With CR-02 rewritten so temperature
    characterisation happens at calibration rather than per cycle, and
    calibration running on Scott's own DMM probe against a drillable witness
    piece, nothing in the design needs a K-type amplifier at all. Both
    probes and the breakout come off -- ~ and one less board to mount.
    Recorded two properties worth more than the saving. 1-Wire carries a
    CRC8, so a corrupt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
2026-08-30 Withdraw the ACS758: I reasoned from a property that did not carry over
    Scott asked where it goes in the circuit. In series with the DC bus,
    same place as the shunt -- and the question is what broke the argument.
    I had recommended it on the strength of the DC clamp working in the
    field. But the clamp survived because it has no galvanic connection to
    the circuit and senses at the jaws; the ACS758 sits in the circuit and
    sends analog down a wire. The property that did the work does not carry
    across, and I never checked that it did.
    Worse, it costs the thing CR-01 depends on: feeding the ESP32 ADC moves
    energy integration into software and back under loop jitter, which is
    exactly what the INA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
2026-08-30 Withdraw the 'long analog path' story; the ratio test now gates the INA228
    Scott rejected the architecture argument I used to justify the INA228,
    and he was right for a reason worse than being wrong: he had already
    told me, during the RF diagnosis, that the PZEM's shunt is integrated
    with the board and has no leads. I built a causal story that contra-
    dicted his own bench observation and then spent a purchase on it.
    What survives is better than what I invented. The voltage channel has
    long sense leads and demonstrably responds to twisting them; the current
    channel has no leads at all, so its error cannot be lead-borne RF, which
    is what makes the scale-constant hypothesis credible. The two-f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
2026-08-30 Session close: bench queue for 2026-08-31, and retire the PZEM
    Recording the queue in order so tomorrow does not re-derive today.
    The headline change is that the decisive PZEM measurement no longer
    requires opening a live box. One simultaneous reading of PZEM current
    against the DC clamp separates the two live hypotheses: exactly 6.0 is a
    documented 50A/300A mismatch with a known fix, exactly 10.0 is outside
    the documented option set entirely. Community search found the failure
    mode is common and well attested but caps at 6x in every reported case,
    which is what makes the reading worth taking -- our own figures were
    eyeball recollections during a run, and 5.5 misremembered as 3.5 is the
    sli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
2026-08-30 E-stop on hand: APT LA39, correct for SR-03's coil-cutting role
    Scott has the E-stop, so CR-09 drops to the encoder alone. Recorded the
    part and, more usefully, the four things that decide whether it actually
    protects anything.
    It is right for the specified role: SR-03 cuts the DC contactor coil
    rather than the bus, and AC-15/DC-13 are coil-switching categories. It
    carries the positive-opening symbol, which is the marking that matters --
    contacts forced apart mechanically, so a welded contact still opens.
    Flagged the NC check first because it is the failure that hides: an
    E-stop on a normally-open contact mounts correctly, looks correct, and
    does nothing.
    Recorded the flyback-diode trap b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
2026-08-30 E-stop contact verified NC on the bench
    Scott metered it: released = closed, pressed = open. Normally closed,
    which is what SR-03 needs -- pressing it drops the contactor coil and
    opens the DC bus.
    Recording the verification rather than leaving the check open, because
    the failure it rules out is invisible: an E-stop on a normally-open
    contact mounts correctly, looks correct in a panel, and protects
    nothing.
2026-08-31 E-stop moves to the AC side; DC contactor retired (Scott's call)
    Scott: 'I want all of the deadly current killed if I have to hit the
    estop.' He had assumed all along that the contactor was on the AC side,
    and asking why it wasn't exposed a real weakness rather than a
    misunderstanding.
    The old SR-03 cut a DC contactor coil, dropping the ZVS stage while the
    rectifier and all mains wiring stayed live -- 8.5 admitted this and
    answered it with 'a reachable plug is the disconnect'. An E-stop that
    leaves 240 V energised is answering the wrong hazard, and the hazard it
    misses is the one present during commissioning with hands near the
    board.
    The revision is also the easier engineering, which is w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
2026-08-31 CR-05 revised: the SSR delivers the step, and arming needs three gates
    Found while writing up Scott's startup sequence that CR-05 says 'switch
    the DC output, not the AC input' -- because a Royer needs a hard step to
    commutate and a slow ramp puts both MOSFETs into conduction at once.
    Section 6.9 moved the contactor to AC yesterday evening without my
    checking that.
    It survives, but by luck. MR-23 had already reassigned the hard step to
    the SSR, so the rectifier's ramp happens behind an open SSR and the ZVS
    never sees it. Had the SSR not already owned that job, 6.9 would have
    fed the Royer a slow ramp and destroyed the IRFP260Ns. CR-05's text has
    disagreed with MR-23 since MR-23 was written;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
2026-08-31 The shunt outlives the PZEM; tomorrow's flat-draw test decides it too
    Scott asked what happens to the shunt if the PZEM is retired. It is a
    separate part -- a bus-bar element in the positive lead -- so retiring
    the board leaves it bolted in the circuit.
    That makes the flat-draw test decide two things rather than one. If CAN
    can integrate energy, the shunt comes out as well: two bolted joints in
    a 33 A bus serving nothing, and every high-current joint is a candidate
    hot spot. If the INA228 is needed, the shunt is already its shunt.
    Recorded the part that closes a loop we spent the evening circling: the
    INA228 reports shunt voltage as a raw register, so the unmarked rating
    becomes irrelevant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
2026-08-31 Contactor selected: Baomain MC-9b-24VDC, and the listing that nearly lost it
    Verified live at $31.16, September 1 delivery. LS Electric Metasol MC-9b
    frame: AC-1 25 A against a 13.6 A load, 3NO mains poles, 1NO+1NC aux,
    24 V DC coil, UL and IEC 60947-4-1.
    Recording how close this came to being rejected. The Amazon spec block
    reads 'AC-1 (Resistive Loads): 25A 24V DC' -- literally a DC contact
    rating, which would make it the wrong part and unsafe on a 240 V feed.
    What saved it was Ui 690 V and Uimp 6 kV on the same page: nobody builds
    690 V insulation into a 24 V DC device. Confirmed against LS Electric's
    frame spec, which is 230/460 VAC with a DC coil option. The listing had
    pasted the coil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
2026-08-31 Power distribution: 24 V primary with split bucks, all from stock
    Scott's architecture -- one 24 V supply feeding the contactor coil
    directly and bucking down for the rest. The S-250-24 (24 V 10 A) is
    already on the shelf at WS2-S3 and there are fifteen LM2596 modules at
    A3-R7C2, so the entire power chain costs nothing.
    Two bucks rather than one, deliberately: a DC pump motor pulls 3-5x
    running current at startup, and sharing a rail drags the logic supply
    down at precisely the wrong moment. A controller brownout mid-cycle is
    an uncommanded state with the field on, which is worth five dollars of
    separation and would be an unpleasant intermittent to chase otherwise.
    Recorded the LM2596's rea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
2026-08-31 Order placed: contactor, panel buttons, INA228 — $62.14 inbound
    Recording what is on the way and, more usefully, what to check when each
    part lands, since three weeks from now the reasoning will not be in
    anyone's head.
    The contactor check matters most: its Amazon listing states the contact
    ratings as '25A 24V DC', which read literally would make it the wrong
    part on a 240 V feed. It is a listing error -- Ui 690 V and LS Electric's
    own frame spec settle it -- but the next person to open the box will see
    the same misleading text, so the note goes in the BOM rather than only
    in the commit.
    Flow sensor deliberately not ordered. No part was chosen because the
    search results are all HVAC padd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
2026-08-31 Flow sensor ordered: Hall-effect, 0.3-3 L/min
    Range brackets a small 12 V pump. Recorded why the obvious search
    results were wrong: the HVAC paddle switches that dominate results are
    sized for 1" pipe and would not actuate at this loop's flow at all,
    reading 'no coolant' forever or sticking closed. A wrong-scale sensor on
    a safety interlock is worse than none, because it looks fitted.
    Fitting notes recorded now rather than at install: threshold above the
    turbine's stall point rather than at it, mount where it stays flooded
    since a parked bubble reads as no flow, supply side for the cooler water
    against an ~80 C housing.
    Noted that this closes the last estimated figure in the power budget.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
2026-08-31 Four-instrument simultaneous read: range theory refuted, 1.77 kW reconfirmed
    Scott took the reading properly rather than from recollection: PZEM
    30.8 V / 3.10 A / 96.1 W against a DC clamp at 33.9 A and a KAIWEETS at
    52.30 V, with the AC clamp in the same frame.
    Current ratio is 10.94. Not 6.0, and not a ratio of any two values in
    the PZEM-025's 50/100/200/300 A range set, where the largest possible
    mismatch is 6x. The shunt-range hypothesis is refuted outright -- which
    is exactly what the test was designed to decide, and it is worth having
    killed rather than left plausible.
    Voltage ratio is 1.70, having been 1.78 and 1.60 on earlier readings. A
    scale error does not move. Corruption on tha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
2026-08-31 Measure tank frequency before running the 19.5 mm coil
    Scott asked how to measure coil inductance with the tools on hand. The
    answer -- pickup loop on the DHO914, derive L from the known 3.96 uF --
    surfaced something with a deadline attached.
    The caps are marked 50 kHz and design-references.md already records that
    both predicted coil bands sit above that. The 19.5 mm coil is predicted
    at ~108 kHz, roughly twice the rating, and it is the coil queued for the
    next session. Running MKPH parts at 2x rated frequency is dielectric
    heating with no warning until one fails, so the frequency measurement
    has to come before the long cycles rather than after.
    Recorded the pickup-loop method specifically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
2026-08-31 Work plan for 2026-08-31 morning
    Nothing ordered lands before Sept 1, so the day is measurement and
    machining. Ordered by value rather than by sequence, because a morning
    rarely survives contact with a bench.
    Block 3a -- the flat-draw test -- is first among the powered work
    because it decides both whether the INA228 gets returned and whether the
    shunt stays bolted in a 33 A bus. It runs on the existing coil, so it
    does not wait on any coil work.
    Block 2, the 5/8" witness bar, gates the entire coil A/B: the 1" bar
    does not fit the 19.5 mm coil, so without a common test piece the two
    coils cannot be compared at all and the coil log has no baseline.
    Block 1 asks whether the 19.5 mm coil is e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
2026-08-31 Block 1 result, plus the coil-bending and flow-test steps the plan lacked
    Block 0 and 1 done: TC sleeve trimmed, PZEM reassembled and installed,
    19.5 mm coil installable pending leg bending.
    Recorded the ordering constraint that the plan implied but never stated:
    Block 3 must run before the coil is swapped, because the baseline
    temperature run is the A of the A/B and needs the 60 mm coil fitted.
    Swapping first destroys the comparison the witness bar exists to enable.
    Added two steps the plan skipped entirely. Annealing before re-bending,
    because copper at an existing bend is work-hardened and cracks when
    re-formed -- and the failure mode is a leak onto a live board, which is
    the hazard the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
2026-08-31 Witness-bar hole moves off mid-length: the probe cannot exit there
    Scott asked whether bending the K-type wire 90 degrees to route it up
    through the coil was acceptable. Bending is harmless -- chromel/alumel is
    ductile. The destination was the problem.
    quickstart-1-8.md specifies cross-drilling at mid-length and that was
    written without checking whether the thermocouple can physically leave
    the hole. A 19.5 mm bore around a 15.875 mm bar leaves 1.8 mm per side
    against a ~2.5 mm braided probe: it does not fit, and forcing it crushes
    the braid and presses the conductors together, which is the false-
    junction failure already recorded. A wire routed up the bore would also
    sit in the strongest p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
2026-08-31 Block 3 result: 310 C baseline, and the draw is flat enough for CAN
    60 mm coil, 1" bar, 30 s, surface sanded bright first so the oxide reads
    this run rather than cumulative history. Peak ~310 C, current 32 A
    climbing steadily to 36.8 A.
    Three runs by three methods now agree at 310-320 C. The reproducibility
    matters more than the figure: a rig that answers differently each time
    cannot be calibrated, and calibration is the whole remaining project.
    This is the 'before' for the coil A/B.
    The flat-draw question resolves in CAN's favour. A 15% rise over 30 s is
    0.5% per second; at 1 Hz that is 30 samples on a monotonic ramp, and
    trapezoidal integration of a linear ramp is exact. Even the midpoin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
2026-08-31 19.5 mm coil first light: 3x the heating on 2/3 the power, and the bus collapses
    100.37 kHz measured with a pickup loop on the DHO914, against 108 kHz
    predicted -- the model was good. Derived inductance 0.635 uH.
    The headline is that it works: 250 C in 10 s against 310 C in 30 s on the
    old coil, roughly three times the heating rate. The surprise is that it
    does so on LESS power. Bus collapses from 52.3 V to 18.0 V under a
    67.3 A draw, so input is 1,211 W where yesterday was 1,773 W. The
    numbers close on coupling alone -- 1773 x 0.17 = 301 against 1211 x 0.66
    = 802, a 2.7x ratio against the ~3x observed.
    Corrected my own first reading: the supply is CURRENT-limited, not
    power-limited. A cur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
    [testrig.cpp]
2026-08-31 TOOL IN A HOLDER -- the near-term goal is met
    A carbide tool is shrunk into a Haas BT30 1/8" holder on the 19.5 mm
    coil. That was the project's stated near-term objective and it is done.
    It took 25 s, a cooldown, then 10 s. Recording that split rather than
    just the success, because it is the supply derating made physical: a
    single long cycle underperforms as the R48 protects itself, falling from
    1,211 W to 795 W by 25 s, and the gap let it recover so the second run
    went in nearer full power on an already-hot holder. Roughly 35 s split
    achieved what ~15 s at sustained full power would have.
    That makes the multi-layer rewind a throughput argument rather than an
    elegance one. Raising tank imp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
2026-08-31 Heat placement confirmed correct, and 4.3's 410 C estimate closed at 285 C
    Photograph of the successful holder shows deep purple confined to the
    clamping section, gold-straw at the shoulder, and the flange, drive
    slots and BT30 taper bright and untouched. My concern that a 30 mm coil
    against a 15 mm clamp length would spread heat onto the taper was
    unfounded -- placement is right and there is nothing to change.
    The band is even around the full circumference, which says the coil sat
    concentric and heated uniformly. Recording that as a free per-cycle
    quality check: an off-centre coil would show as an uneven band, and no
    instrument in this shop reports concentricity any other way.
    The bigger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
2026-08-31 Reheat repositions a shrunk tool; depth collars specified
    30 s + cooldown + 15 s released and re-seated an already-shrunk tool to
    a chosen depth, against 25 + 10 for the original insertion. The
    difference fits -- a reposition is a release and a re-seat in one heat,
    and Haas's table shows shrink-out running 15-20% longer than shrink-in.
    The capability matters more than the numbers: a mis-set depth is
    recoverable rather than a ruined holder, which is worth knowing before
    it happens on a tool that matters.
    Still purple at ~285-290 C on both cycles, and the colour line still has
    not passed the nose taper. Heat placement holding under repetition is
    better evidence than the first photo was -- on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
2026-09-02 Close OQ-5: controller moves to a 38-pin ESP32, test rig stays on S3
    The board change was agreed in conversation yesterday and never written
    down -- the docs still assumed the Super Mini everywhere, so the loop was
    genuinely open and Scott was right to ask.
    Two boards, two purposes. The test rig stays on the S3 Super Mini
    because it works: OTA proven, TWAI clean, buttons and LED done. Its
    footprint work stays valid and in use; it just does not carry to the
    controller. That also means today's INA228 I2C work goes on the S3 with
    no conflict and nothing waiting.
    The controller moves to a 38-pin ESP32, ~5 of which are already in
    stock. The strongest reason is not the pin count but the instabil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
2026-09-02 INA228 bring-up sketch on a separate 38-pin ESP32
    Scott's call, and better than mine: test I2C on a new dev board rather
    than adding it to the working rig. The rig has OTA, TWAI, buttons and a
    duration ladder all proven, and there is no reason to risk that to try a
    new peripheral. It also starts the ESP32 port incrementally instead of
    as one migration later, and tests I2C on the silicon that will actually
    carry it.
    Raw register access rather than the Adafruit library, deliberately.
    During bring-up a wiring fault should read as a wiring fault, not as a
    library that 'doesn't work' -- one fewer layer between the operator and
    the chip.
    The sequence matters too: prove the board is alive BEFORE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
    [ina228_test.cpp]
2026-09-02 Board identified: NodeMCU-32S, the variant with the proven footprint
    Silk reads 5V rather than VIN, and pin names are P-prefixed rather than
    D/GPIO. Both tells match NodeMCU-32S, which is the variant this shop
    already has a proven NodeMCU-32S_38pin_THT footprint for -- so the
    controller PCB needs no new footprint and takes no exposure to the
    mirroring failure that has hit two footprints here already.
    That was the last open item on the 6.12 board decision, and it landed
    the favourable way: had it been a DOIT DevKit-V1 the footprint work
    would have had to be redone from measurements.
    Recorded the instruction to mark the other boards in the bin. There are
    at least four different 38-pin produc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
2026-09-02 OTA on the INA228 bring-up board; flashed and verified booting
    Flashed to the NodeMCU-32S over USB. Boot output confirms
    ESP32-D0WD-V3 rev 3 at 240 MHz and I2C initialising on sda=21 scl=22.
    Scan returns nothing, which is the correct answer with no INA228 wired
    yet -- a clean negative from working firmware rather than a failure.
    Added WiFi and OTA because the same argument that justified it on the
    test rig applies here: the board should not have to be carried to a
    bench for every firmware change.
    Hostname is shrinkfit-ina228, deliberately different from the rig's
    shrinkfit-testrig. Both boards will be on the same network and an mDNS
    collision would send a flash to the wrong one -- a failur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
    [ina228_test.cpp]
2026-09-02 espota needs the laptop on the device's VLAN -- recorded after the second time
    The INA228 board joined IoT cleanly, reported its OTA server running,
    and answered mDNS -- and espota still failed with 'No response from
    device' because the laptop was on 192.168.1.x against the board's
    192.168.30.x.
    espota runs backwards from the intuition: the host invites and the
    DEVICE connects back to the host. Across VLANs with no reverse route
    that return connection never lands, and every device-side symptom looks
    healthy because the device side is healthy. That is what makes it cost
    time -- there is nothing wrong to find on the board.
    Same fault as the test rig's OTA bring-up on 2026-08-27. Recording it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
    [ina228_test.cpp]
2026-09-02 Correct the misleading touch-test banner (NOT YET FLASHED)
    The banner told the operator to touch VIN+/VIN- and watch VSHUNT move.
    That cannot work with R002 fitted: the pads are shorted through 2
    milliohms and a finger is around a megohm, so the shunt wins by a factor
    of ~500 million. Scott tried it, saw nothing, and reasonably wondered if
    the board was faulty. It was my instruction that was wrong.
    The touch test only works AFTER R002 comes off and the inputs float.
    What actually proves the chip before rework is MFG_ID 0x5449 and
    DEVICE_ID 0x2281, both of which read correctly -- so the gate for
    desoldering is already passed.
    *** THE BOARD IS RUNNING THE PREVIOUS BUILD. *** OTA needs the la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
    [ina228_test.cpp]
2026-09-02 INA228 bring-up complete on the NodeMCU-32S
    Genuine part confirmed by MFG_ID 0x5449 and DEVICE_ID 0x2281, not merely
    an address that acknowledges. R002 removed, VIN+ to VIN- now 35 MOhm --
    open for any purpose here, since against a 750 uOhm shunt that diverts
    two parts in a hundred billion. Analog front end responds. OTA verified
    end to end.
    Done on a board deliberately separate from the S3 test rig, so a working
    machine was never at risk while a new peripheral was brought up.
    Recorded two bad instructions of mine rather than quietly dropping them.
    The touch test cannot work with R002 fitted (2 mOhm against a finger's
    megohm) and, worse, does not work after removal either -- touching both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
2026-09-03 Pin map for the NodeMCU-32S controller — the doc the schematic gets built from
    Scott's point, and he is right: the instability argument justified
    headroom, not paralysis. With a board that has spare GPIOs a requirement
    change costs a pin reassignment rather than a respin, so there is no
    reason not to narrow the design down now.
    Settling the pin map before touching KiCad because changing the MCU
    re-pins everything -- the existing schematic still carries the S3 Super
    Mini as U1 and is stale against essentially every decision since.
    Two constraints recorded that would each cost a board. CAN RX must not
    land on GPIO12: a transceiver's RX idles HIGH, GPIO12 must be LOW at
    boot, and the module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
2026-09-03 Pin map: PCF8574 for the lamps, not dropping the display
    An earlier draft led with 'drop the TFT and four pins come back', which
    framed a decision Scott had already taken as the problem. He wants a
    display and encoder for settings; the display is not what needs to give.
    The lamps are. They are slow static outputs -- exactly what an I2C
    expander is good at -- and the I2C bus already exists for the INA228, so
    moving them costs zero MCU pins and about a dollar. GPIO 25/26/27 come
    back as clean spares.
    That takes the board from 'the only spares are strapping pins' to real
    headroom with everything fitted. roadmap.md reached for the same part
    when the Super Mini was the constraint, and the reaso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
    [ina228_test.cpp]
2026-09-03 Record the telnet console, the macOS no-telnet trap, and a misfiled commit
    Telnet carries the console that OTA does not, and crosses the VLAN that
    espota cannot -- the device connects back to the host for espota, while
    telnet is an ordinary outbound connection. That asymmetry is what makes
    it worth having: firmware pushes still need the laptop moved to IoT,
    watching the stream does not, and the laptop cannot live on IoT.
    Also noted that macOS ships no telnet client, which is a two-minute
    confusion the first time and a documented one thereafter.
    Flagged that the telnet firmware landed inside bd0fbc7 -- a commit whose
    message is entirely about the pin map -- because I used 'git commit -a'
    an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
2026-09-03 Bring the proven NodeMCU-32S symbol and footprint into the controller project
    Both already existed in sln-geo-aux-heat, on a board that was built and
    works -- so the controller needs no new symbol and no new footprint, and
    takes no exposure to the mirroring failure that has hit two footprints
    in this shop. That was the payoff for identifying the board as a
    NodeMCU-32S rather than a DOIT.
    Added the GPIO -> symbol-name -> PIN NUMBER table, which is the artefact
    that actually prevents the wrong-pad failure. On this symbol names and
    numbers deliberately disagree -- names are GPIO, numbers are header
    position, and pin number 26 is the pin named P32. Wiring by number lands
    nets on the wrong GPIOs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
2026-09-03 TFT on board one, lamps on a PCF8574 -- and the driver changes to a MOSFET
    Both decisions taken. The expander returns GPIO 25/26/27, so the board
    has genuine headroom with the display fitted rather than only strapping
    pins spare.
    The part that matters is not the pin count. PCF8574 outputs are
    quasi-bidirectional: LOW sinks 25 mA, but HIGH is a weak pull-up
    sourcing only ~100 uA. That breaks the 2N3904 pattern proven on the SSR,
    because an NPN needs base current sourced INTO it -- 100 uA at hFE 150
    is about 15 mA of collector current, marginal for a lamp and worse over
    temperature.
    The failure mode is what makes it worth catching now: dim or
    intermittent lamps that work on a bench and sag i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
2026-09-03 Schematic rev B: NodeMCU-32S, 24 V primary, lamps off the MCU
    Regenerated against docs/pinmap.md. ERC 0 violations, and all 38 U1 pins
    verified independently -- nets on the named pins, no-connects on the
    rest, flash pins 17/18/19/35/36 explicitly NC.
    Changes from rev A: U1 is the NodeMCU-32S (proven symbol and footprint
    copied from sln-geo-aux-heat rather than redrawn); MAX31855 header
    deleted; power is 24 V in with two LM2596 bucks (5 V logic, 12 V motors
    and lamps) rather than a single 12->5; the 220k/10k bus divider and its
    filter cap are gone because the INA228 measures bus voltage now; and
    lamps, encoder, cycle start/stop, DS18B20 and the TFT are added.
    Two bugs ERC caught that readin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
    [shrink-fit-controller.kicad_sch]
2026-09-03 Footprints assigned; netlist verified against pad numbers
    18 components, 0 without a footprint, ERC 0 violations, and all 20
    critical nets confirmed landing on the correct U1 PIN NUMBER in the
    exported netlist -- CAN_RX on 26, SSR_DRV on 13, ENC_A on 34. That is
    the check that catches the wrong-pad failure; ERC does not.
    Generated project-local 2.54 mm headers rather than using KiCad's stock
    PinHeader library. The stock parts use 1.7 mm pads on a 1.0 mm drill,
    which on this shop's bit set snaps UP to 1.181 mm and leaves a 0.259 mm
    annulus against pcbmill's 0.25 mm gate -- passing by 9.5 microns, which
    is not a margin, it is luck. 1.78 mm pads give 0.299 mm and match the
    NodeMCU-32S_38pin_TH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
    [shrink-fit-controller.kicad_sch]
2026-09-03 Real footprints for the LM2596 modules and the EC11 -- both were placeholders
    Scott caught both. I had used generic 1x04 and 1x05 headers, which
    silently encoded a decision I never raised: that the buck modules and
    the encoder mount OFF the board and the headers are just wiring to them.
    LM2596: the proven LM2596_Module_THT footprint already existed in
    sln-geo-aux-heat, same source as the NodeMCU footprint -- 2.0 mm pads on
    a 1.0 mm drill, 0.410 mm annulus. Modules now mount on the board, which
    deletes eight flying leads. Pin order IN+/IN-/OUT+/OUT- confirmed from
    the source symbol before wiring, because a swapped in/out on a buck
    destroys it.
    EC11: a 1x05 header could not map onto the real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
    [shrink-fit-controller.kicad_pcb, shrink-fit-controller.kicad_sch]
2026-09-03 All four ordered parts arrived; the R002 is stocked, not taped to the board
    The 2026-08-30 order is in hand and on the books. The BOM's "keep the R002
    bagged and taped to the module" instruction is retracted, because its only
    purpose was keeping the return option open inside the 30-day window if the
    flat-draw test retired energy dosing. The module is staying: at 0.66 coupling
    the 19.5 mm coil collapses the bus 52.3 V to 18 V, and 1 Hz CAN telemetry
    cannot integrate a load that moves like that, so CR-01 needs the INA228.
    The resistor is stocked separately at Scott's direction (InvenTree part 1172,
    B3-R3C2) with its tolerance recorded as unverifiable — 2 mOhm reads as a dead
    short on every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
2026-09-03 PCF8574 and 2N7002 lamp drivers on the board as real parts
    The expander was a 4-pin header standing in for a decision. It is now a
    DIP-16 with real pin numbers so the stock Package_DIP footprint maps
    1:1, A0-A2 grounded for 0x20 (INA228 is at 0x40, no collision), 100 nF
    decoupling, and three 2N7002 low-side drivers. J13 becomes the lamp
    connector: +12V plus one cathode per lamp.
    The PCF8574 has no firmware; lamp logic lives in the ESP32, which
    writes one byte to 0x20. Recorded on the sheet that firmware should
    rewrite that byte every loop rather than only on change -- the expander
    holds its outputs if the MCU hangs, and a refreshed byte turns a hang
    into a lamp that stops responding instead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
    [shrink-fit-controller.kicad_sch]
2026-09-03 PCF8574 ordered; the listing does not know which variant it ships
    Bridgold 5-pack, $8.69. Title says PCF8574AP, package contents say
    PCF8574P -- the exact ambiguity flagged when the part was specified.
    Same pinout and same board either way; only the I2C address differs
    (0x20 vs 0x38 with A0-A2 grounded). Recorded that the firmware constant
    is set by reading the chip, not the listing, and that the bring-up
    sketch's scan reports the truth.
2026-09-03 R48 CAN protocol recorded from source, with the 56.1 vs 50 A trap
    Protocol taken from craigpeacock/Huawei_R4850G2_CAN's r4850.c rather than
    from memory: 125 kbps extended, request 0x108040FE at 1 Hz, telemetry
    0x1081407F with sub-ID in data[1] and a big-endian uint32/1024 in
    data[4..7], set commands on 0x108180FE with data[1] selecting voltage or
    current and online or offline.
    The trap worth the commit: the current command is a FRACTION of the
    rectifier's maximum, and the community code hard-codes that maximum as
    50 A for the R4850G2. Ours is an R48-3000e3 labelled 56.1 A. Copying the
    constant would mis-scale every current limit by ~12% -- a commanded 30 A
    landing near 33.7 -- and nothing o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
2026-09-03 CAN Stage 1 on the bring-up board: listen plus the 1 Hz request, no set commands
    TWAI in NORMAL mode on GPIO 14 TX / GPIO 32 RX -- not listen-only,
    because the R48 answers requests rather than volunteering, so the
    request frame has to be transmitted, and a normal node ACKs, which some
    R48 firmware wants to see before it keeps talking. The request is a read
    (0x108040FE, eight zeros) and cannot change anything on the rectifier.
    Decodes 0x1081407F replies: sub-ID in data[1], big-endian uint32 in
    data[4..7], divided by 1024. Tracks BOTH 0x81 and 0x82 as candidate
    output-current sub-IDs and prints both, because the community README and
    the community code disagree, and the bench decides which one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
2026-09-03 Record the CAN Stage 1 wiring and the decided test order
    CAN first at the rig with the R48 on mains and its DC output open; the
    PZEM box opens once afterwards to bring the shunt's Kelvin leads out;
    INA228 calibration then happens at the bench supply in CC mode. Scott's
    sequencing, and it means the box is disassembled once rather than twice.
    Wiring written down with the two traps inline: CAN RX on GPIO 32, never
    GPIO 12 (a transceiver's idle-HIGH RX on a must-be-LOW strapping pin
    means the board never boots), and the 220||270 termination because there
    is no 120 R in stock and the module's own three resistors are 10 k, not
    120 R -- Scott read the 01C marking, which is EIA-96 for 10 kOhm.
2026-09-03 WITHDRAW the Huawei CAN protocol: our rectifier is a Vertiv, not a Huawei
    Section 6.13 recorded the Huawei R4850G2 protocol and applied it to a
    Vertiv R48-3000e3. Different companies, different products. The
    datasheet says Vertiv on the front page; I searched for 'R48 CAN', found
    the extensively-documented Huawei part, and never checked that the model
    numbers actually matched. Every ID and encoding in 6.13 is wrong for
    this unit.
    6.14 has the real one, from anikrooz/Emerson-Vertiv-R48 -- a repo whose
    title names our exact model and which was reverse engineered from the
    Emerson M820B controller. Only the 125 kbps bit rate survives.
    The behavioural difference matters more than the IDs. The H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
    [ina228_test.cpp]
2026-09-03 Measured: the 2-pin JST is not CAN, and the card does not expose it
    Both JST pins float below 0.2 V against DC- with the R48 running. A
    recessive CAN pair idles at ~2.5 V on both lines by design, so this is
    not a CAN bus and never was. Section 2.1 reasoned its way to 'almost
    certainly CAN-H/CAN-L' from pin count and finger width, wrote 'confirm
    before connecting', and then firmware got written against the
    unconfirmed assumption anyway.
    That also explains the bench evidence cleanly. tx_err=128 with rx_err=0
    was the no-node-on-the-bus signature, not a protocol mismatch -- a CAN
    node ACKs any well-formed frame regardless of ID, so a rectifier
    listening on those wires would have acknowledged ev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
2026-09-03 ROOT CAUSE: the breakout card omits the comms interface by design
    An Amazon listing for the same class of R48-3000e3 adapter states it
    outright -- not the original factory interface board, does not have the
    original factory communication interface, only input and output. That is
    Scott's card: mains in, DC out, one 2-pin enable line, which is exactly
    what the meter found.
    So nothing was wrong with the transceiver, the wiring, the 220||270
    termination, or the firmware's bus setup. tx_err=128 with rx_err=0 was
    an honest report that there was no CAN node on those wires, because
    those wires are not CAN. The instrument was right the whole time and I
    kept looking for faults in things that were wor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
2026-09-03 Datasheet confirms CAN; the pinout is unpublished and the forums do not need it
    Vertiv's own datasheet, Control and Monitoring section: alarm and status
    reported via CAN bus to system controller. So CAN is factory capability
    reaching the card-edge connector, not a community hack.
    The same spec table corrects 6.14's scaling question: output current
    62.5 A at -48 V and current limit set point 0 to 62.5 A. The label's
    56.1 A is the same 3000 W at 53.5 V -- constant-power supply -- and it is
    62.5 that the CAN set command scales against, not the label.
    Recorded why Scott's instinct that this should not be a mystery is right
    and still leads nowhere: the pinout is genuinely unpublished across the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
2026-09-04 Module manual confirms the CAN feature set and explains the missing pinout
    UM1R481000e3 Table 1.7 lists what the rectifier accepts from a
    controller: Turn On/Off, Current Walk-in, HVSD Reset, Current Limit
    Adjustment, Voltage Regulation -- and what it reports back, including
    output voltage, output current and current limit setting. Everything
    CR-11 wants is a documented factory feature, not a community hack.
    The structural finding is why the pinout has been so hard to find: the
    module manual says to refer to the documentation of the SYSTEM the
    rectifier is installed in. The module plugs into a NetSure shelf and the
    backplane pinout belongs to the shelf's manual. The remaining document
    to ch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
2026-09-04 Documentation route closed: the backplane pinout is not published anywhere
    Searched the NetSure 731 A41 shelf manual in full, 38 pages. Its only
    connector table covers AC and DC distribution; the shelf manual treats
    the rectifier slot as a black box. Combined with both R48 datasheets,
    the 28-page module manual, four manual hosts, both community repos and
    two forums, this is no longer a search failure -- the document is not
    public.
    Also confirmed there is nothing to order. Scott was right: the eBay
    tail adapter is the same power-only card he already has, verified from
    its own product photo -- two DC terminals, a 3-position mains block, no
    comms. No CAN-bearing adapter has been found for sale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
2026-09-04 CORRECTED R48 protocol: IEEE-754 floats, not scaled integers
    The Endless Sphere thread Scott pointed at has far better protocol data
    than the GitHub repo, and it corrects the encoding I recorded in 6.14.
    Values are 32-bit big-endian floats, not (volts*10-320)*0x40000/10.
    Decoded all six of the post's example byte strings and every one lands
    exactly on its stated meaning -- 42240000 = 41.0 V minimum, 426A0000 =
    58.5 V maximum, 3F9AE148 = 1.21 = 121% of rated. That is settled.
    Second correction, and it would have been a silent 21% error: current is
    commanded as a FRACTION of rated, and the datasheet's 62.5 A IS the 1.21
    value. The 100% base is ~51.7 A, which independently matches the
    annotati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
2026-09-04 Two-node CAN bench test: verify our own hardware before blaming the rectifier
    Our CAN hardware has never been checked against a known-good node. It
    looked fine only because it was wired to something that may not be a bus
    at all, so there was nothing to fail against -- and tx_err=128 with
    rx_err=0 is equally consistent with OUR transceiver not driving as with
    nothing being there. This separates the two.
    Same binary on both boards, with GPIO27 choosing the role at runtime:
    open means talker, grounded means listener. Deliberate, so neither board
    can end up being 'the one with the wrong build' -- a failure mode that
    would look exactly like a hardware fault.
    Both nodes ACK each other, so a work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
    [can_loop.cpp]
2026-09-04 CAN bench test: read it from one port, and let the second node be any ESP32
    Two problems with the first cut, both raised by Scott.
    Reading it. It printed on each board separately, so proving a round
    trip meant watching two USB ports at once and correlating counters by
    eye -- a bad way to run a test whose whole value is a clean yes/no. The
    listener now echoes every frame back on ID 0x124 and the talker reports
    whether it came home, so ONE monitor on the talker tells the story and
    the listener only needs power. It blinks GPIO2 per frame so it can be
    seen working with no monitor at all. The talker also prints an explicit
    PASS/FAIL/MARGINAL verdict naming the likely cause, rather than raw
    count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
    [can_loop.cpp]
2026-09-04 Add 'ping' to the dev board rather than repurposing it for the CAN test
    Scott asked whether the board we have been developing on gets taken over
    for the two-node test. On inspection it should not, for a reason that
    matters more than convenience: that board, its SN65HVD230 and its wiring
    ARE the suspect. A test between two fresh boards would pass and prove
    nothing, because it would exonerate hardware that was never accused.
    Its TWAI config is already identical to can_loop's -- 125 kbps, NORMAL,
    GPIO14/32 -- so it needs no reflash to be the node under test, only a
    mode that pings something that will answer. 'ping' toggles the 1 Hz
    frame from the R48 request to a plain 0x123 and reports round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
2026-09-04 Ping mode: clear the controller on entry, and count a jam as one fault
    Both fixes came from actually running it on the board rather than from
    reading it, and both would have produced a confident wrong answer at the
    bench -- the exact failure this test exists to rule out.
    Entering ping mode now restarts the controller. Measured: after the
    rectifier attempt the controller sits error-passive with frame N still
    retrying, so twai_transmit only ever returns queue-full and ping reported
    '0 sent' with no verdict at all. That failure belongs to the PREVIOUS
    test, not to the peer, and a test that inherits a jam cannot tell the two
    apart. Toggling ping now always starts clean.
    A jammed TX also reprin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
    [ina228_test.cpp]
2026-09-04 can_loop: tell a jammed transmitter apart from an unacknowledged bus
    Flashed the second board (ESP32-D0WD-V3 from B3-R6C3) and read it back,
    which turned up a diagnostic gap worth closing before Scott wires
    anything. With no transceiver connected the counters stay at 0/0/0 and
    the queue simply fills, because GPIO32 floats and the controller waits
    for a bus-idle that never comes -- it never errors. That is nothing like
    the dev board against the R48, which shows tx_err=128 with bus_err
    climbing in thousands. Both present as 'it will not transmit', and
    reading either as the other sends you to the wrong end of the problem,
    which is precisely what this two-node test exists to prevent. The verdict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
    [can_loop.cpp]
2026-09-04 The transceiver modules were terminated all along; correct the record
    Scott looked at the module under good light and read R2 = 121 = 120 ohm,
    sitting directly across CANH/CANL. R1 = 103 = 10k is the fixed RS slope
    resistor, which is also why the board exposes no RS pin. Two modules
    therefore already make a correct 60 ohm bus and need nothing added.
    I had written the exact opposite into can_loop.cpp, status.md and a
    commit message: that these modules have no onboard termination and need
    a 220||270 pair at each end. That came from an ambiguous '01C' read off
    one resistor earlier in the evening, which I turned into a confident
    statement and then cited as established. Nothing measured it. The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
    [can_loop.cpp]
2026-09-04 Fix the listener's role at build time; the jumper was the wrong battle
    Four rounds went into a role jumper that would not seat. The pin position
    was right the whole time -- Scott's count of 'ninth from the USB end' and
    his ohmmeter both checked out, and the live pin scan caught the pin
    briefly going low and back, which was almost certainly his own probe
    completing the circuit. Intermittent contact in a female header, not a
    wiring error.
    The jumper only ever existed so one binary could serve both ends. That is
    a convenience, and it stopped being one the moment it cost more than it
    saved, so env:can_loop_listener fixes the role with -DROLE_FIXED=0.
    Nothing to seat and nothing to misread. The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
    [can_loop.cpp]
2026-09-04 Give the listener a self-test; silence was unanswerable
    Scott pulled the ESP off the breadboard and asked me to check it, and I
    could not answer -- which is the actual defect. A listener that hears
    nothing produces identical counters whether its transceiver is connected
    or not: echoed 0, rx_err 0, bus_err 0, either way. The talker had a
    self-diagnostic and the listener had none, so exactly half the bus was
    unverifiable at exactly the moment it mattered.
    It now sends one frame of its own every 5 s and reads the outcome. The
    transmit path runs through the same transceiver the receive path uses, so
    one probe distinguishes all three states: cannot queue with every counter
    still 0 means no trans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
2026-09-04 Record the two-ended-wire trap that cost the evening
    The bench CAN test drove the second ESP32 into a hard boot loop as soon
    as the boards were 'grounded' together. The ground wire's far end was in
    the dev board's POSITIVE RAIL. Scott found it by looking; no measurement
    we took would have.
    Worth writing down because every diagnostic I ran was individually
    correct and collectively misleading. DC volts between the two grounds
    read 0 V -- true, and useless, because both grounds were at the same
    potential and the wire was on neither. Continuity from the landing point
    to ground beeped -- also true, and it was the near end, which was fine
    all along. I never had the far end tested. Disconnect-fixe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
2026-09-04 Record the GND-next-to-flash-bus trap on the NodeMCU-32S
    The dev board went from healthy to unbootable tonight purely through
    wiring changes, ending at 'flash read err, 988' -- the bootloader unable
    to read flash at all -- and recovered completely the moment every wire
    came off. Both boards now sit clean with zero checksum and zero flash
    errors.
    The layout invites it: counting from the USB end on the 3V3/5V edge,
    CMD/SD3/SD2 occupy positions 2, 3 and 4, and GND is position 6. Three
    holes. Aim for GND, land two early, and you are on the SPI flash bus with
    no warning other than the board never coming up again.
    The fix is to stop counting. The GND between P19 and P21 on the opposite
    edge has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
2026-09-04 Suspect the breadboard before the wiring
    Scott lifted the ESP32 off the breadboard and the anomalous readings
    disappeared -- no voltage between the USB shell and the ground pin, none
    of the floating values we had spent the evening interpreting. The
    breadboard was bridging or leaking.
    That one observation retro-explains most of tonight: voltages between
    pins that should have been shorted, flash read err 988, boot loops that
    came and went with wire changes, and measurements that moved when nothing
    electrical had. Every one of those got diagnosed as a wiring error, and
    every diagnosis was individually plausible -- which is exactly why it
    survived so long.
    An intermittent bridge is indistingui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
2026-09-04 Correct the previous entry: it was the INA228, not the breadboard
    Scott found the INA228 module was still connected to 3V3 and GND with
    only its signal wires pulled, and removing it is what cleared the phantom
    voltage between the USB shell and ground. The breadboard was fine. I had
    committed the opposite as fact one message earlier.
    The mechanism is worth having written down: the INA228 has ESD diodes
    from VIN+/VIN- to its supply rails, so with those inputs still on the
    shunt the module conducts from the measured circuit into the logic 3V3
    rail and ground through diodes never meant to carry it. Pulling a
    module's signal wires does not remove it from the circuit -- its power
    pins and its inp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
2026-09-04 Open item: INA228 input protection and ground reference
    Scott raised this from a bench measurement -- the INA228 module with only
    its signal wires pulled still produced a phantom voltage, because its
    power pins and input ESD diodes remained connected. The mechanism
    generalises badly: bus live with logic supply down puts the measured
    circuit into the 3V3 rail through diodes rated for static discharge.
    Harmless at bench millivolts, not harmless at 48 V.
    Recorded as OPEN rather than answered, with the presumed fix (matched
    series resistors plus power sequencing) marked as presumed. A diode was
    considered and set aside -- it does not address common mode and it adds a
    drop in the sense path.
    Th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
2026-09-04 Self-test both nodes in NO_ACK mode: both CAN chains are proven good
    The evening's central question is answered, and not the way any of my
    theories predicted. Each board now transmits a frame in TWAI NO_ACK mode
    with self-reception: the frame still leaves through CTX, is driven onto
    the real bus by the transceiver, comes back through its receiver and
    re-enters on CRX. Both boards return their own frame with tx_err=0 and
    bus_err=0.
    So both CAN chains are good -- controller, CTX, driver, bus, receiver,
    CRX -- and the dev board's transceiver was never the reason the R48
    stayed silent. That is the finding the whole two-node exercise was built
    to produce, and a self-test reaches it without needi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
2026-09-04 Found it: the dev board's transceiver has a dead CANH driver
    Isolated, powered at 3.3 V, input grounded to command a dominant, the dev
    board's SN65HVD230 reads 0 V on BOTH CANH and CANL -- the low side pulls
    CANL down and CANH is dragged to meet it through the 120 ohm
    termination. The fresh module from RB-25 in the identical setup reads
    3.3 V / 0 V, a real driven dominant, and a healthy idle module reads
    1.4 V on both.
    The reason this took a day is that a device holding CANH at ground clamps
    the bus for every node on it. Three modules were bussed together, so
    every measurement returned ~0.89 V regardless of what was done -- and a
    brand-new replacement module measured exactly as dead, becaus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
2026-09-04 RETRACT the dead-transceiver diagnosis: I misparsed the measurement
    Scott replied 'three point three volts and zero volts at CANL and CANH'.
    I read that as CANH 3.3 V, CANL 0 V -- a driven dominant, proving the
    fresh module good and the original dead. He was answering two questions
    in one line: 3.3 V was the module's SUPPLY, and BOTH bus lines were at
    0 V. A brand-new module therefore measured identically to the suspect
    one, and nothing was shown to be dead.
    I announced it as confirmed, wrote a TRAPS entry, and committed it, all
    from a sentence that carried fewer numbers than the question had asked
    for. The entry stays, marked retracted, because the failure mode is worth
    more than the delet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
2026-09-04 Root cause: a supply that reads 3.3 V and cannot deliver 10 mA
    Module 3 -- never in service, genuine VP230 -- produces 0 V on both CANH
    and CANL in BOTH commanded states on the dev board's wiring, with D
    confirmed low at the module's own ground reference, 3.3 V across its
    supply pins, 0 ohm ground to the MCU, correct termination and no shorts.
    Producing neither recessive bias nor dominant is not a broken driver. A
    powered transceiver biases the bus to about VCC/2 recessive -- 1.4 V
    measured on a working one earlier -- and splits it dominant. Neither
    means the chip is not running, and a reading matching no valid state of
    the part indicts the supply or the measurement rather than the function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
    [ina228_test.cpp]
2026-09-04 ROOT CAUSE: the transceiver supply folds under the driver's load
    Watched the module's 3V3 pin during a 25 s dominant hold: it dropped to
    0 V, recovered, dropped again, cycling throughout. A relaxation
    oscillation through series resistance in the supply path -- the chip
    loads it, it collapses, the chip browns out and stops drawing, it
    recovers, repeat.
    Every symptom of the day was this one fault at different load levels.
    The original breadboard path collapsed even under recessive's 10 mA,
    which read as a dead chip: 0 V on both bus lines in both states. The
    direct rewire improved the path by about one contact's worth -- enough
    for recessive, which came alive at a 1.5 V bias, not enough for th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
    [can_loop.cpp]
2026-09-04 The blue VP230 modules do not drive: measured at the chip leads
    Every input on three separate SN65HVD230 modules measured directly at
    the SOIC lead on a bench supply that held steady: VCC 3.3 V, GND 0 V, RS
    0.6 V (slope control), D toggling at 125 kHz with a 1.65 V average on
    the pin. The chip is alive at 13 mA, biases the bus to 1.5 V, and its
    receiver output follows D. The driver never engages -- CANH and CANL stay
    at 1.5 V under a CAN-shaped stimulus, and the supply current does not
    move. Datasheet says CANH >= 2.45 V, CANL 0.5-1.25 V, about 30 mA.
    Two of my own tests were invalid and are recorded as such. The 40 s DC
    hold on D is not a CAN test and would fail a good transceiver with a
    d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
    [ina228_test.cpp]
2026-09-04 Draft the SN65HVD230 module return report
    Scott asked for a write-up to return the three transceiver modules. The
    technical body is complete and does not depend on the purchase record:
    test setup, the full lead-by-lead measurement table against SLOS346O
    section 8.5, the two out-of-spec secondary numbers (14 kOhm input
    resistance vs 20 kOhm min, 2.2 V receiver output vs 2.4 V min), and the
    conclusion that the driver never engages under either a DC or a CAN-rate
    stimulus on any of three units including one never previously powered.
    Placeholders remain for vendor, order, date, listing, quantity, price and
    the full IC marking. Those live in InvenTree part 19 and under the
    microscope respectivel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
2026-09-05 Return report: add the LCSC clone-market corroboration
    LCSC's own search for SN65HVD230DR lists the genuine TI part at $0.70
    alongside six third-party parts carrying the same number at $0.20-0.50,
    with published specs that differ from TI's (70 mA supply on one, 5 Mbps
    on another -- different dies). A populated module retailing at $2.66
    cannot contain a $0.70 genuine die plus board, passives, headers and
    margin, so it is built from that tier. Recorded as corroboration, not
    proof: the measurements are the evidence, this is the supply-chain
    explanation for them.
2026-09-07 can_loop: HOLD_TOGGLE jig -- 125 kHz drive on D for the second board
    Sibling of HOLD_DOMINANT. The DC hold was shown today to be an invalid
    CAN test; this puts the CAN-shaped stimulus on whichever board it is
    flashed to, so the same drive test can be run on the new ESP32 and its
    Waveshare -- the comparison that separates 'this transceiver' from 'this
    board's wiring'. Under a meter a working driver averages ~2.6/~1.6 V; a
    driver that never engages leaves both at the ~2.2 V recessive bias.
2026-09-07 CAN loopback PASSES: 16/16 echoes, zero errors, on Waveshare transceivers
    First attempt succeeded once both ends were proven before the bus went
    between them. Dev board 2.8/1.6 V and new board 2.7/1.6 V under the
    125 kHz drive test; onboard 120 ohm on each Waveshare; grounds common
    through the Mac with no bonding wire. 16 round trips, ~1.4 ms RTT, every
    counter zero on the talker.
    The listener's residual rx_err/bus_err are from its own pre-connection
    probes and are decaying on successful frames, which is what a healthy
    CAN node does with a stale error count.
    Status records the chain: the three blue modules never drove, measured
    at the chip lead with every input verified; the Waveshares dri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
2026-09-07 Rewrite CAN firmware to the Vertiv R48 protocol (Stage 1, read-only)
    Huawei R4850G2 constants removed -- wrong company, wrong part, withdrawn
    in 6.13. Implements 6.14/6.15 as read from the anikrooz source: the
    two-frame handshake plus gimme5 every 10 s until HELLO on 0x00860F8003
    (data[3] 0x58 first contact, 0x5D on recovery -- either accepted, and
    which one is printed), then control byte 0x01 and the settings query
    every 6 s. Telemetry is any frame with data[0]==0x11, decoded /1022 and
    x2 per the source with the raw bytes printed beside it, because neither
    constant has been checked against a meter and first contact is where
    that happens.
    Boots into LISTEN, which transmits nothing and print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
    [ina228_test.cpp]
2026-09-07 status: CANable termination is a switch (shipped ON); PO-0160 received
    Scott measured 120 ohm across the adapter's CANH-CANL and then found the
    termination is on a switch rather than a jumper -- corrected in the
    stock notes, the part notes and here. It ships ON and must be OFF before
    the adapter joins any bus that is already terminated: the R48 bus has
    the Waveshare's 120 ohm plus the rectifier's own, and even the loopback
    pair would make it a third terminator, which is the 40 ohm trap from
    this morning. Received as stock 791 at Electronics Bench; order left
    PLACED for Scott to complete himself.
2026-09-07 status: dev board flashed with the Vertiv Stage 1 build, boots LISTEN
2026-09-07 R48: the JST floats relative to both output rails (measured 2026-09-05)
    With the rectifier on and 53.4 V across the output, both JST pins read
    0 V to DC- and 0 V to DC+. Two points 53 V apart cannot share the JST's
    potential, so the pins are a floating high-impedance node that follows
    the meter -- not referenced to the DC output at all. A CAN transceiver
    on the output ground, even idle, would read ~0 to one rail and ~53 V to
    the other through its input resistors.
    Distinct from 6.14.1, which was measured through a transceiver later
    shown unable to transmit and proves nothing. Two candidates remain:
    enable/inhibit per the forum, or CAN on an isolated control ground. The
    tests that separate th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
2026-09-07 R48 JST resolved: CAN on an isolated ground, unterminated
    55 kOhm across the pair in both polarities and OL both ways in diode
    mode is a CAN transceiver's differential input, not an opto; shorting
    the pair with 53.4 V on the output changed nothing, so it is not an
    inhibit. With yesterday's floating reading the picture is complete: CAN,
    referenced to an isolated control ground that the breakout does not
    bring out. Scott's reading was right; 6.14.1's 'not CAN' was measured
    through a transceiver that could not transmit.
    The 55 kOhm carries two wiring consequences. The port is unterminated
    (terminated would read ~120), so our end supplies the only terminator --
    CANable switch ON here, where OFF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
2026-09-07 status: CANable sniffer parked as open -- powered, right bitrate, silent
2026-09-07 FIRST CONTACT: the R48-3000e3 answers over CAN. Vout 53.10 V vs 53.4 V on the meter
    Dev ESP32 on a brick, telnet, CANH/CANL only to the JST, no ground wire.
    Sixty seconds of LISTEN produced nothing -- the rectifier does not speak
    until spoken to. r48init produced 160 frames in 40 s with every error
    counter at zero, and the status frame decodes to 53.10 V against 53.4 V
    on the meter, so /1022 holds to 0.6 %. Iout reads 0.0 unloaded and the
    x2 stays unverified.
    Three corrections to the recorded protocol, all measured on the wire.
    The reply IDs are 0x060F8003 and 0x060F8007; the source's 0x00860F80xx
    values carry the MCP2515 library's extended-frame flag in bit 31 and can
    never match a 29-bit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
    [ina228_test.cpp]
2026-09-07 R48 telemetry decode verified under a real load: Iout = raw/512, Vout = raw/1024
    ZVS 10 s cycle with the DC clamp on the bus. Peak raw 0x86BA = 34490
    decodes to 67.4 A against 68 A on the clamp; the source's x2 was missing
    the same /1024 the voltage uses. Vout raw is always a multiple of 1024,
    so it is whole volts and /1022 was an approximation of that.
    The cycle also reproduced the August bench operating point from the
    rectifier's own telemetry: current limit at ~68 A with the bus folding to
    20 V, against 67.3 A at 18 V measured then. Both instruments put the
    limit about 8 % above the 62.5 A datasheet figure.
    Current telemetry lags 2-3 s on the fall -- a filter in the rectifier --
    which C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
    [ina228_test.cpp]
2026-09-07 Stage 2: ONLINE set commands behind the 48 V clamp, held with a 10 s refresh
    r48v <volts> and r48i <amps>, ONLINE only (0x21 / 0x22). The clamp is
    inside the send function, not a parameter: 41-48 V, the IRFP260N
    ceiling. OFFLINE commands are absent from the file entirely because they
    persist in the rectifier across power cycles.
    A held setpoint is re-sent every 10 s because the forum says ONLINE
    values need refreshing within ~15 s; r48v off, r48stop and canReset all
    clear the hold, and the rectifier reverts on its own within ~30 s of
    silence. That revert is the safety property and is the first thing the
    bench test checks, before anything is allowed to depend on it.
    Both commands refuse unl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
    [ina228_test.cpp]
2026-09-07 Stage 2 measured: 45 V obeyed, 2.5 V/s walk-in, ONLINE timeout ~37 s, revert is unconditional
    First command to the rectifier. r48v 45 sent 42 34 00 00 -- IEEE-754 as
    6.15 says -- and the output walked 53 to 45 at one volt per status frame,
    about 2.5 V/s, with the meter agreeing at 45. Held for 35 s under the
    10 s refresh. Then total silence: 45 V for 36.8 s, then a walk back to
    53 at the same slew, complete at 40 s.
    Three things now measured rather than quoted. The walk-in slew applies
    both ways, so a step command is a 3 s ramp at the output and CR-01
    timing has to allow for it. The ONLINE timeout is about 37 s, not 30,
    and it is an unconditional revert to the rectifier's own default -- the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
2026-09-07 Stage 2: clamp proven on the wire -- 50 V asked, 48.0 sent; amber LED pattern noted
2026-09-07 Stage 2: clamp confirmed on the meter at 48 V; released
2026-09-07 status: Stage 2 verified end to end; r48i under load is the one remaining Stage 2 check
2026-09-07 Current limit verified under load; the 100 % base is ~57 A, not 51.7
    r48i 50 sent 0.967 of a 51.7 A base and the rectifier delivered 55.6 A
    on telemetry, 55 A on the clamp, with the bus folding to 15 V -- down
    from 68 A / 20 V uncommanded. The command works. The base does not: two
    independent estimates, 55.6/0.967 and 68/1.21, both land at ~57 A, which
    is 3000 W at 53 V. The rectifier's 100 % is its rated power at nominal
    voltage, and the datasheet's 62.5 A was never this unit's 1.21 value --
    its real one is the 68 A we measure. R48_I_BASE is now 57.0, flagged as
    a single-point calibration until a second level proves it is a gain.
    With that, every Stage 2 property is a measurement: voltage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
2026-09-07 Linearity point at 45 A is inconclusive: telemetry 48 A vs clamp 44 A at a 9 V bus
    First disagreement between telemetry and clamp all day, at the lowest
    bus voltage seen. Either the clamp was read early in a slowly-settling
    plateau or the rectifier's current telemetry over-reads at low output
    voltage; the data cannot say which. Three of four base estimates
    cluster at 56-57.5 A and the 57 A base stands, but linearity is not
    proven and a line through the telemetry values gives a +15 A offset,
    which is not physical. Recorded as such rather than fitted.
    The bus folded to 9 V, below the floor set for the ZVS gate drive. It
    ran. Any further point goes up to 62 A at ~17 V, never down. Amber LED
    co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
2026-09-07 45 A point resolved: both instruments saw the same hunting; base is a gain at ~57 A
    Scott's clamp hunted 43-48 A through the cycle, the same band as the
    telemetry's 44.5-48.2. They agree: the rectifier's current-limit loop
    oscillates at a 9 V bus into the ZVS, a resonant load at its gate-drive
    floor. An unstable operating point, not a measurement error and not a
    nonlinear command. The mid-band gives a base of ~58 A; four estimates
    now sit at 56-58, so the base is a gain with no offset and 57.0 stands.
    The useful thing it exposes is a control constraint. The current limit
    cannot throttle this coil below ~45 A because the bus folds under 12 V
    and the CC loop hunts, so fine power control has t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
2026-09-07 Return report: genuine parts worked on the identical wiring the hiBCTR modules failed on
2026-09-07 R48 JST harness: yellow = CAN H, blue = CAN L, no ground -- the polarity that works
2026-09-07 Calendar corrected from git; 62 A point, base 56 +-1.5, CC stability range, OTA-stall trap, quarantine done
    Every date I wrote from 09-04 onward was two days early. The commit
    timestamps are the truth: the long bench day was 09-04, the Waveshares
    and the loopback pass were 09-06, and first contact with the R48 plus
    all of Stage 2 is 09-07. Headings in status, requirements, the return
    report, the sniffer and the InvenTree notes now agree.
    The 62 A point is clean -- telemetry 60.1, clamp 60, bus 17 V, steady --
    and closes the calibration: base 56 +-1.5 A, linear to ~3 A over
    45-62 A, no demonstrated offset. A two-point line through points only
    12 % apart manufactures an offset out of noise, s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
    [ina228_test.cpp]
2026-09-07 CANable verified on the live R48 bus: 139 frames/30 s, clean, saw the 45 V setpoint land -- keep it
    On the rectifier session the sniffer hears every ID -- the R48's
    replies, our keep-alives, our set command -- and independently decoded
    the status frame carrying 0xB400 = 45 V, which is the first time a third
    instrument uninvolved in the exchange has witnessed a setpoint on the
    wire. The loopback failure was the floating-brick pair's common mode and
    no longer matters. Termination switch ON here: the R48 port brings none,
    so the Waveshare's plus the CANable's is the correct two.
    cansniff: a frame arriving in the same read as the E reply was being
    glued onto it; the poll now takes the first CR-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
2026-09-07 The 37 s revert is a session timeout, not a setpoint timeout
    45 V held 99 s with refresh and keep-alive running, then 108 s more with
    the refresh off and only the 6 s keep-alive, and the rectifier never
    left 45. It forgets a setpoint when the controller goes quiet, not when
    the setpoint stops being repeated. The 10 s refresh in the firmware is
    redundant and stays as belt-and-braces; CR-01's one hard obligation on
    this bus is to keep the session alive with any traffic inside ~37 s.
2026-09-07 status: stopped 14:10; meter confirmed 45 V on keep-alive alone; CANable kept
2026-09-07 ina228_s2_esp32: Stage 2 by USB; base-56 build now on the dev board
    The previous USB flash used the Stage 1 env, which does not compile the
    Stage 2 block where R48_I_BASE lives, so the corrected constant never
    reached the board. Stage 2 needs its own USB env because the OTA one
    cannot cross the VLAN from the main LAN. Flashed and confirmed by the
    STAGE 2 status line.
2026-09-07 Firmware inventory: three rigs, none complete; production build fails; PO status corrected
    Scott asked whether the dev board and the assembly-table rig run the same
    software. They do not. The S3 test rig runs testrig.cpp and is the only
    thing that fires a cycle; the NodeMCU-32S dev board runs ina228_test.cpp
    and holds every verified piece of R48 CAN; and the production main.cpp,
    whose CAN module is a stub and whose HMI is stubbed, targets the S3
    that 6.12 already ruled out and does not compile for want of two
    Adafruit libraries. Nothing verified today is in the production tree.
    That sets the design session's scope in order: make main.cpp build on a
    NodeMCU-32S env, port the Vertiv code into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
2026-09-07 Merged controller firmware builds for the first time (merge steps 1+2)
    The production tree has never compiled in this checkout. Now env:controller
    builds main.cpp + energy.cpp + r48_can.cpp for the NodeMCU-32S.
    Step 1, make it build: config.h rewritten from pinmap.md for the classic
    ESP32 -- SSR on 4, mains-drop on 16, CAN on 14/32, buttons on 34/35,
    encoder on 13/19/15, lamps on the PCF8574, interim status on GPIO 2 --
    with every §6.9/§6.10 semantic carried across: the SSR delivers the step,
    firmware has one path to mains and it only opens the contactor, the
    E-stop is hardwired and GPIO 36 is read-only status. The MAX31855 is gone
    (CR-02 rewritten, no on-board TC), so the controller need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
2026-09-07 Merged firmware runs a timed cycle on the bench; E-stop bench guard fixed
    env:controller_bench on the dev board: console, ARMED, dur 5, start ->
    GPIO 4 high for exactly 5000 ms, cycle logged, COOLDOWN entered. The
    merged controller now reproduces the S3 test rig's job on the board that
    will replace it.
    The bench caught a real bug on the first try, which is what it is for.
    The E-stop check was bypassed in doPrecheck() but left live in
    doHeating(), so the cycle faulted 5 ms in on a floating GPIO 36. Fixed
    inside estopClosed() rather than at each call site: guarding callers one
    by one is precisely how those two got out of step.
    Scott then asked the right question -- how do the buttons work at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
    [main.cpp]
2026-09-07 Port WiFi/OTA/telnet, the duration button and the blink-count LED into the controller
    Scott corrected two things and both were right: the duration control is a
    BUTTON, not the encoder, and the indicator is ONE LED showing the setting
    as a flash count. I had been designing the finished PCB instead of the
    bench rig. This ports the test rig's proven pattern verbatim in
    behaviour, including the reason it looks the way it does -- the display
    is continuous while IDLE because a press that reports the setting is a
    press that also changes it, so the readout cannot live on the button.
    The duration button goes on ENC_SW_PIN (GPIO 15). It is already in the
    pin map, it has an internal pull-up where 34-3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
    [main.cpp]
2026-09-07 Route the whole console through say(); fix a String passed to printf %s
    The first telnet session into the merged controller printed the banner
    and then nothing. Cause: status() and handleLine() were written before
    the say() layer existed and still used Serial.printf, so every reply went
    to USB only and the remote console looked dead while working perfectly on
    the cable. Twenty-eight call sites converted; the check that catches it is
    grep for Serial.printf/println, since a dual-output layer does nothing
    unless every caller actually uses it.
    Also fixed a real defect found while reading: one printf passed a String
    object to %s, which is undefined behaviour with varargs and happened to
    be in th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
    [main.cpp]
2026-09-07 Declare what is fitted instead of faking it: ESTOP_FITTED and CONTACTOR_FITTED
    Scott chose the flag over the resistor and was right. A 10k pull-up on
    GPIO 36 makes the firmware report an E-stop closed forever when no E-stop
    exists -- true at the pin, false about the machine, and invisible a month
    later. A flag announces the compromise at every boot and on every status
    line, the way FLOW_INTERLOCK=0 already does.
    Confirmed with him: there is no AC contactor and no E-stop chain. The ZVS
    is fed straight off the R48 and the SSR is the only actuator -- the S3
    test rig's topology, which is how every cycle to date has run. That is now
    stated in the firmware rather than assumed by it. mainsDrop() n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
2026-09-07 Second, discrete status LED on GPIO 25 -- the onboard one was an assumption
    Scott went to wire the rig and asked how he is supposed to see which
    duration is selected. Fair: STATUS_LED_PIN was GPIO 2 on the assumption
    that this NodeMCU-32S has a user LED there, and many of these boards
    carry only a power LED. The duration blink-count has been playing to a
    pin that may go nowhere.
    Both pins now get the same pattern. GPIO 2 stays in case the board does
    have one; GPIO 25 is a discrete LED wired to the board and is the one to
    trust. 25 is free by design -- pinmap.md moved the lamps to the PCF8574
    expander -- and it is LAMP_GREEN's pin on the finished board, so the wire
    is not throwaway.
    The wid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
2026-09-07 Bench mode reads the buttons, and a boot self-check found START floating
    Scott wired the pull-ups and wanted to test the switches, but BENCH_MODE
    was ignoring the buttons -- a workaround for floating input-only pins
    that external resistors make unnecessary and that would have defeated the
    test. Buttons are live in both builds now.
    Added a boot self-check on the two input-only pins, and it paid for
    itself on the first run: START reads LOW with nothing pressed while STOP
    reads HIGH, so 35's pull-up is good and 34's is not. The consequence was
    in the very next line of the log -- the floating pin read as a press and
    fired a 10 s cycle the moment the board armed. That is the exact hazard,
    and it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
    [main.cpp]
2026-09-07 Add a 'pins' command that maps header positions to GPIOs; both pull-ups verified
    The START pull-up chased us for three rounds: the meter read 3.3 V on
    Edge A position 15 while the chip read GPIO 34 LOW, which cannot both be
    true and meant my Edge A count -- inferred from a photo in the 14-17
    range, unlike positions 6, 8, 9, 13 and 19 which Scott measured today --
    was suspect.
    'pins' settles that class of question by asking the board: it pulls up
    every safely-readable GPIO, prints which one is being held LOW, and
    separately reports the input-only pins as-is since 34-39 have no internal
    pull-up and cannot be probed that way. Same trick that identified the CAN
    role pin this morning. It restore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
2026-09-07 pinmap: add measured header positions; Edge B had a phantom GND and was off by one
    Scott's duration button would not work on the Edge B position 5 I gave
    him and works on 4. Cause: the pin nearest the USB on Edge B is CLK, not
    GND. My list had a phantom GND at the front, so every Edge B position I
    handed him was one too high -- which also means the SSR belongs on B7,
    not the B8 I specified.
    The document now carries a physical position table separate from the
    KiCad symbol-pin table, because they are different numbering systems and
    confusing them cost an hour today. Each entry is marked by how it was
    established: Edge A is measured throughout (6 and 19 read 3.3 V apart,
    CAN works on 8 and 13,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
2026-09-07 Add 'watch': log input transitions for 30 s, and it settled the button question
    Three round trips went into 'the buttons do not work' with me guessing at
    wiring from a chat window. 'watch' samples START, STOP and the duration
    button every pass and prints each transition with a timestamp and the
    state, so Scott can press at leisure and the log is read afterwards -- no
    timing to coordinate.
    It answered immediately. GPIO 35 logged eight clean press/release pairs
    including a fast double, so the input path, the pull-up and the sampling
    all work and the firmware is not at fault. GPIO 34 and GPIO 15 never
    moved, pressed or not.
    It also disposed of the lockout theory: from a fresh boot both pins r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
    [main.cpp]
2026-09-07 Bench rig: move START/STOP to GPIO 27/26 with internal pull-ups
    Scott's call after the input-only pins cost an afternoon. 34/35 stay in
    pinmap.md for the PCB, where printed pull-ups make them the right choice
    and they preserve the flexible pins. On a breadboard they are the wrong
    trade: no internal pull-up so an unconnected pin floats LOW and reads as
    pressed -- it fired a 10 s cycle by itself the first time the board armed
    -- they cannot be identified by grounding so the pins command is blind to
    them, and a pull-up landing on the switch side of the wire turns
    disconnecting a wire into starting a cycle.
    26 and 27 are free by design, have real internal pull-ups, and take a
    button straight to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
    [config.h, main.cpp]
2026-09-07 START and STOP verified on the merged controller; the lockout was CR-04 cooldown
    One watch pass caught the whole path. START on GPIO 27 fires a cycle,
    STOP on GPIO 26 aborts it mid-heat at 6.66 s of 10 and logs completed:0.
    Clean transitions, no bounce, no phantom presses, no external resistors.
    It also explained Scott's lockout theory, which was right. Three START
    presses in the log do nothing because the board is in COOLDOWN, and the
    fourth works the instant it reaches IDLE -- CR-04's 60 s dwell after a
    cycle, doing exactly its job. It was invisible until the watch made the
    state machine legible alongside the pins.
    Recorded what the input-only pins actually cost, since pinmap.md keeps
    th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
2026-09-07 Shorten COOLDOWN to 3 s under BENCH_MODE; show the value at runtime
    The real 60 s dwell is right for the machine -- it is the only thing
    stopping a warm holder being re-heated, which is the failure that
    permanently enlarges bores -- but on the bench it ate three button
    presses in a single test. BENCH_MODE now uses 3 s and env:controller
    keeps 60.
    The value is printed in the status line as 'cooldown Ns' in both builds
    rather than only announced in the bench banner. A safety constant that
    differs between builds should be checkable on the running board, not
    inferred from which preprocessor branch was taken. Bench build confirms
    3 s; the real build takes the other arm of the same #if and will s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
    [config.h, main.cpp]
2026-09-07 Merged controller verified at the assembly table: SSR fires, CAN session live
    Dev board at the machine, DC breaker off, driven over telnet from the
    bench. R48 reports online at 53 V and 0.0 A -- a live handshake and
    keep-alive session with the rectifier, passive because bench mode
    commands no setpoints, and the zero current confirms the breaker really
    is open. The SSR fires on a cycle, which also confirms Edge B position 7
    as GPIO 4 and retires the last inferred entry in the physical pin map.
    One board now does everything the S3 test rig does -- buttons, duration
    ladder, LED blink count, timed cycles -- plus rectifier telemetry and
    remote control it never had. Merge steps 1 through 3 are co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
2026-09-07 Full button-driven cycle captured at the machine: 9 ms to SSR, 15000 ms exact, telemetry in the log
    One capture holds the entire chain. START pressed at 431253 ms, HEATING
    at 431262 -- nine milliseconds from finger to SSR closed -- and the cycle
    ran 15000 ms to the millisecond before logging completed:1.
    The log line carries rectV:53 and rectI:0.0, which is the part that
    matters beyond this test: every cycle now records the rectifier's own
    voltage and current beside the dose. That is the independent channel
    CR-11 asks for, from a different vendor's silicon, and the S3 test rig
    had no way to know those numbers existed.
    The merged controller is now demonstrably a superset of the rig it
    repla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
2026-09-07 Production build armed and commanded the rectifier to 41.5 V
    env:controller pushed over OTA once the Mac was back on IoT -- espota's
    reverse connection cannot cross the VLAN, which is why the earlier
    attempts from the main LAN failed with 'no response from device' while
    ping and telnet worked fine.
    The real CR-05 arming gate then ran end to end for the first time: bus at
    or above 40 V over CAN across three telemetry samples, 30 s since
    power-up, then setCurrentLimit(55) and setVoltage(41.5), then IDLE. The
    rectifier's telemetry went 53 V to 41 V on the controller's command, so
    the firmware is now driving the machine's operating point rather than
    observing it.
    cooldown 60s in the status lin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
2026-09-07 Decode the R48's 0x41 info frames: setpoint, current limit, temperature, AC input
    Chasing Scott's fan question turned up something worth more than the
    answer. The rectifier streams 0x41 frames carrying big-endian floats, the
    same encoding as the set commands, and two of them mirror values we had
    just commanded -- 0x01 came back as our 41.5 V and 0x03 as our 0.982
    current fraction -- which identifies the set rather than guessing at it.
    0x04 is internal temperature and 0x05 is AC input voltage, reading 20 degC
    and 241.9 V against a 240 V shop supply.
    Both are now in R48::Telem, in the status line, and written into every
    cycle log as rectC and acV. That gives CR-07 a thermal channel the design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
2026-09-07 Fan sweep: the knee is 47 V, so quiet and FET margin have no compromise position
    Descending 1 V sweep from 48 V, 15 s per step, Scott counting by ear. The
    fan is quietest only at 48 V and audibly speeds up at 47 -- the first
    step down -- then grades to full by 41.5. Not a threshold, and it starts
    immediately.
    That kills the hope of a quiet middle ground. 48 V is exactly
    BUS_VOLTAGE_CEIL, the point of least FET margin, so every volt of margin
    costs noise from the very first volt. BUS_SETPOINT_V stays at 41.5 V:
    noise is an annoyance, and 200 V parts with ringing on top of a 130 V
    idealised peak are not. Revisit only after VR-05 scopes actual Vds.
    Recorded the mechanism as unexplained rather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
2026-09-07 Fan curve complete: ramps 47 V, full by 42 V; 41 V is the protocol floor
2026-09-07 First real heating cycle under the merged controller: 56.7 A, 16 V, 5000 ms, ~900 W
    41.5 V setpoint with a 55 A limit into a test slug, coolant running, DC
    breaker closed, fired from telnet with telemetry captured throughout.
    Current climbed to 56.7 A against the commanded 55 -- inside the 1.5 A
    uncertainty on the 56 A base -- the bus folded to 16 V in constant
    current, and the SSR opened at exactly 5000 ms. One log line carries the
    rectifier's voltage, current, internal temperature and AC input beside
    the cycle, which is more than the S3 test rig could see at all.
    The cycle also corrected the info-frame decode. 0x01 is not a readback of
    the commanded setpoint: it is the ACTIVE regulation t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
2026-09-07 6.16 resolved: the bus floats, so a logic-ground INA228 is out; and fix a placard that stated the opposite of the design
    Measured DC- to controller logic ground with the machine running: 1.7 V
    DC fluctuating, 18 V AC steady. Two floating systems with capacitive
    coupling, which is not a fault but the design -- SR-10 closed with no
    continuity from either DC rail to chassis, and SR-11 withdrew the earth
    bond because bonding creates a hazard by giving the coil a defined
    potential relative to an earthed machine.
    That kills the simple INA228 arrangement. On logic ground with inputs
    across a bus-side shunt the common mode swings about +-25 V, and the
    part's -0.3 V minimum is violated on every main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
    [config.h]
2026-09-07 End-of-day handoff: state, and the next session's order of work
    Merged controller left running the production build at the assembly
    table, IDLE with the SSR open, armed at 41.5 V, reachable on telnet. The
    S3 rig is still in place but now redundant.
    Next session starts with the two earth readings that finish 6.16, then
    the INA228 topology decision that gates the schematic, then VR-11 shunt
    calibration which is what unlocks energy dosing. The safety chain is step
    4 and is precisely the list of NOs the status line prints.
2026-09-07 TRAPS: two pin-numbering systems, and what confusing them cost
    The KiCad symbol numbers pads by header position and the bench counts
    holes from the USB connector, and the two disagree -- P32 is pad 26 and
    also Edge A position 13. Neither is wrong; they answer different
    questions. But 'pin 26' means two different holes depending on who is
    speaking, and an hour went into a duration button that would not work
    because the instruction was given in one system and executed in the
    other, compounded by a phantom GND at the front of my Edge B table that
    made every position on that edge one too high. Uncaught, that would have
    put the SSR on GPIO 16 -- the mains-drop pin -- in copper.
    The rule is to na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
2026-09-08 Record the two spare 121R CAN terminators in InvenTree as part 1179
    Scott overruled me and was right. I argued against a part record on
    tidiness grounds -- two hand-made pairs from a kit with 28 of each
    resistor, no forecast demand, a record to maintain. His argument beats
    it: the workflow is brainstorm, design, search inventory, order what is
    missing. Something that exists but is not recorded returns a confident
    false negative at precisely the moment it matters, and gets bought
    again. That is the same failure as inventory-search-the-requirement, and
    it costs money rather than neatness.
    Part 1179 in Electronics/Passives/Resistors, 2 off at B3-R3C6 with the
    CAN gear, keyworded so a search fo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
2026-09-12 status: the 121R terminator label is printed, and the part has a home
    Records the print (job QL810W-103, template 12) and sets default_location on
    part 1179 to B3-R3C6, which was left blank when the part was filed on 09-08.
    Blank was the safer-looking choice -- location-policy says default_location is
    where a SPARE goes home and must never be a project bin, and these two were made
    FOR this project. But they are not allocated to it: they were built on 09-04,
    never fitted, and B3-R3C6 is the bin-wall drawer that holds the CAN gear
    generally. So the drawer really is home, and leaving the field blank would have
    reproduced the same false negative the part record exists to prevent.
    The note also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
2026-09-26 testrig: banner and comment said 10 s per flash; the ladder has been 5 s since 2026-08-31
    The 2026-08-31 ladder change edited DUR_LADDER and the runSeconds/5 divisor
    but left the boot banner and the rationale comment describing the old
    10..60 s ladder. Rewrote both to the 5..30 s ladder and kept the 10 s history
    as history. Rejected deleting the old rationale outright: the coupling-ratio
    argument is why the floor is 5 s and still applies.
